povdoigt/Apex/Station_sol/README.md

# Apex
git hub du projet Apex
coucou les copains 

# Install / Uninstall

Curently the install and uninstall files are instaling the test vertion (testqt). It is only a desmonstrator and placeholder for the future etiration of it.

# ApexActual
Curently the main vertion a Apex, it while the structure for telemetry reads is present it isnt used. Mainly a way to show how the ui looks on the ground station.
