povdoigt/Apex/PCB/invoice.pdf

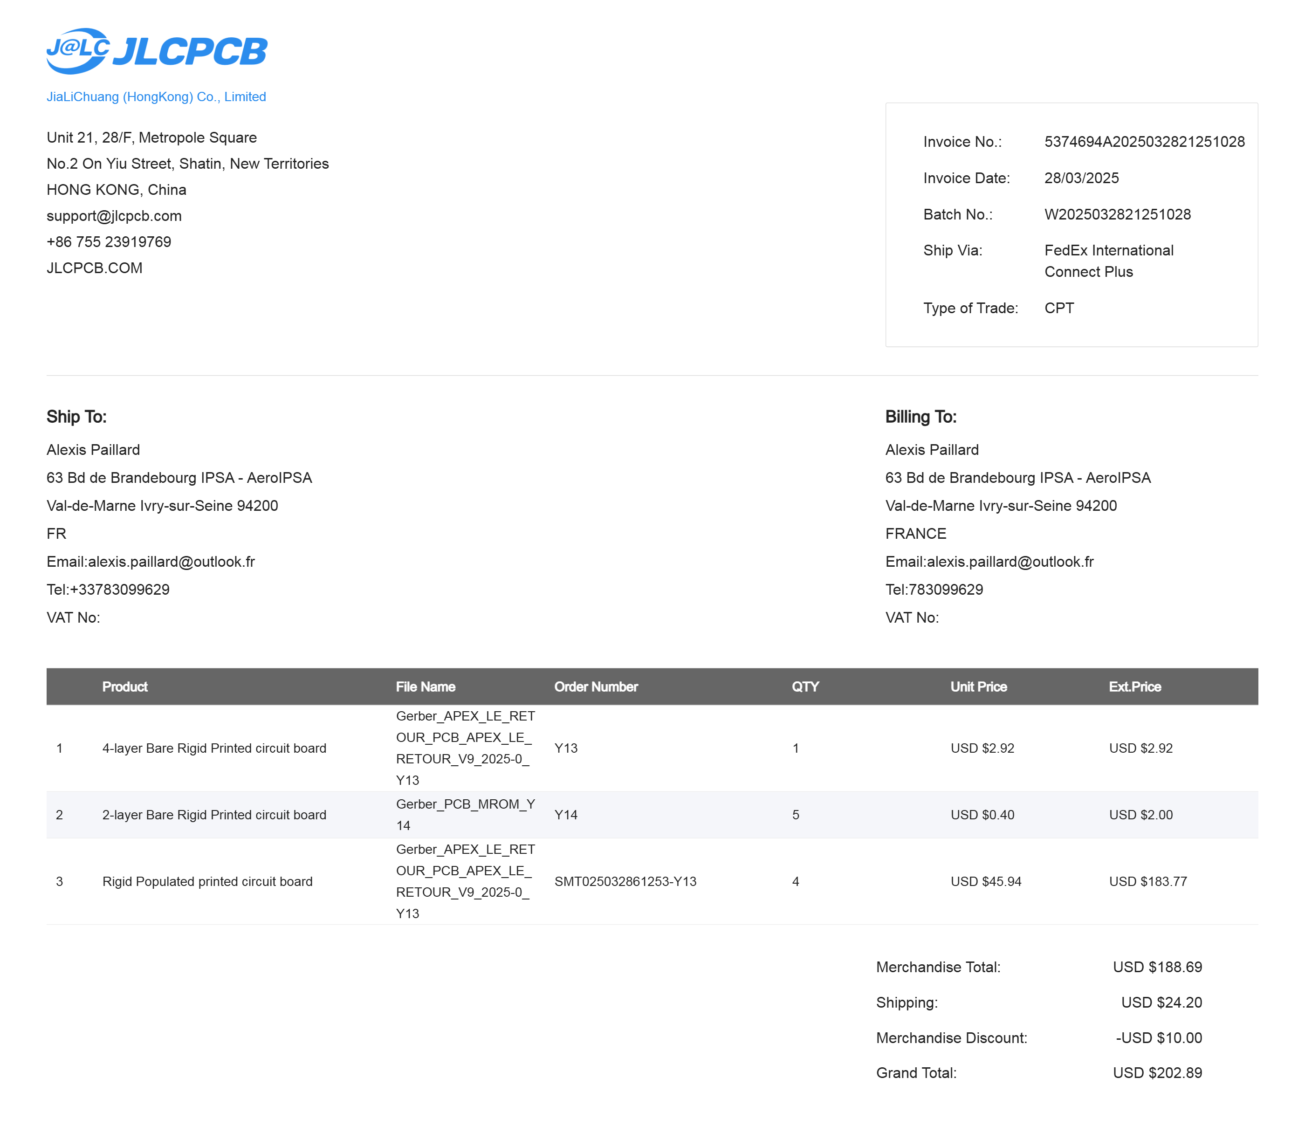
[picture p21: page 1]
