povdoigt/Apex/PCB/PCB_PCB_APEX_LE_RETOUR_V9_2025-04-03/Hole.pdf

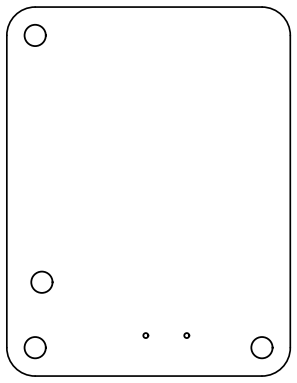
[picture p22: figure]
