povdoigt/Apex/PCB/invoice (1).pdf

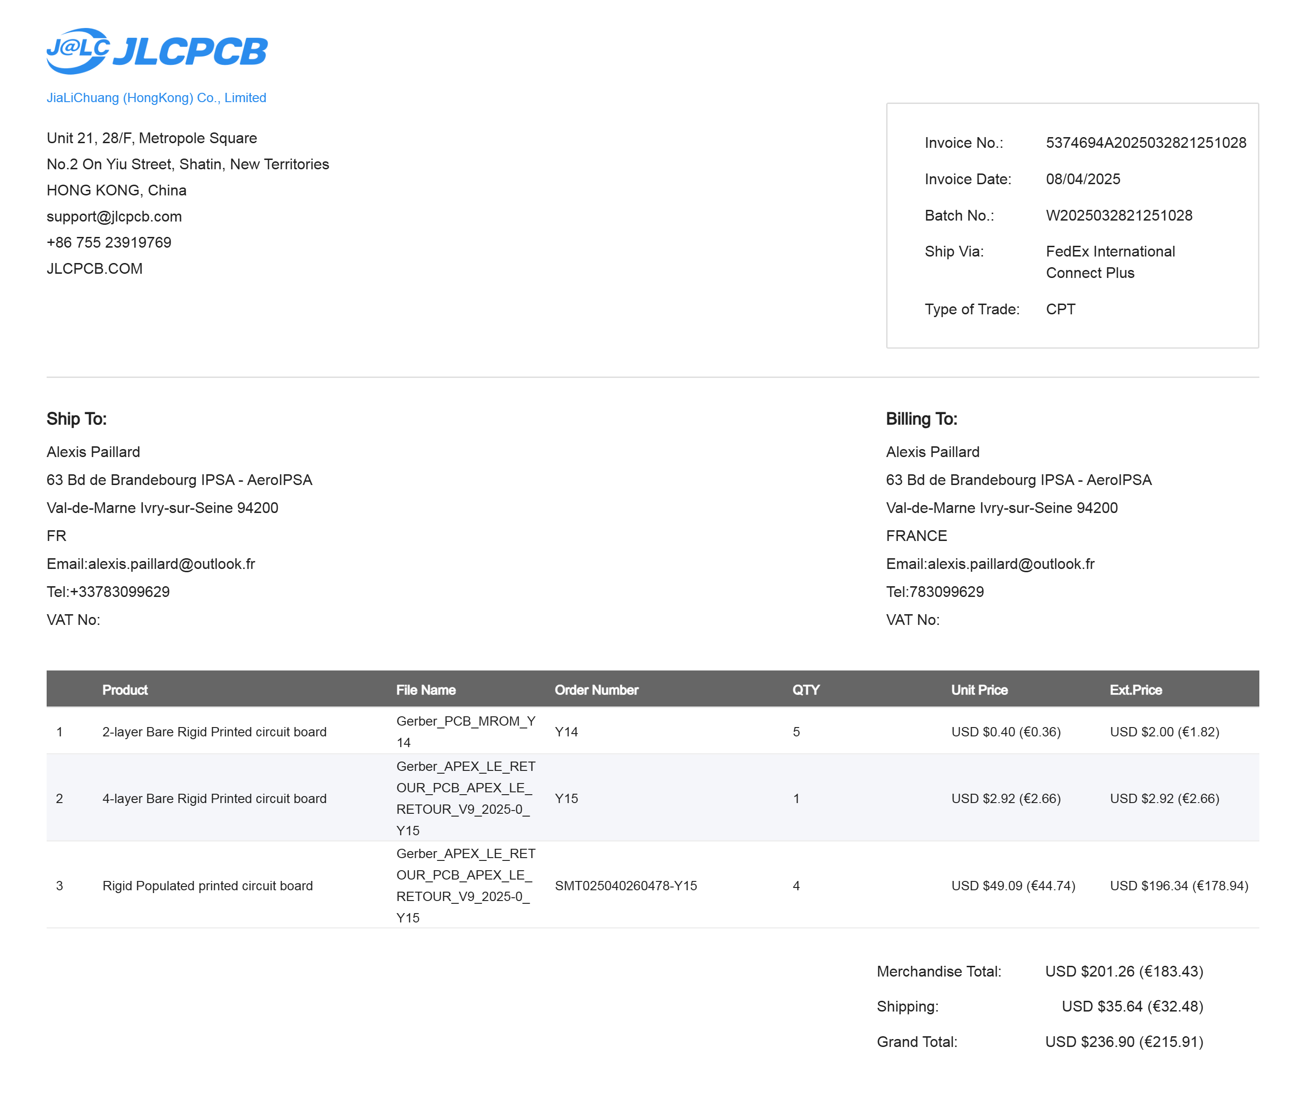
[picture p23: figure]
