povdoigt/Apex/APEX_DOC/APX_algo.drawio.png

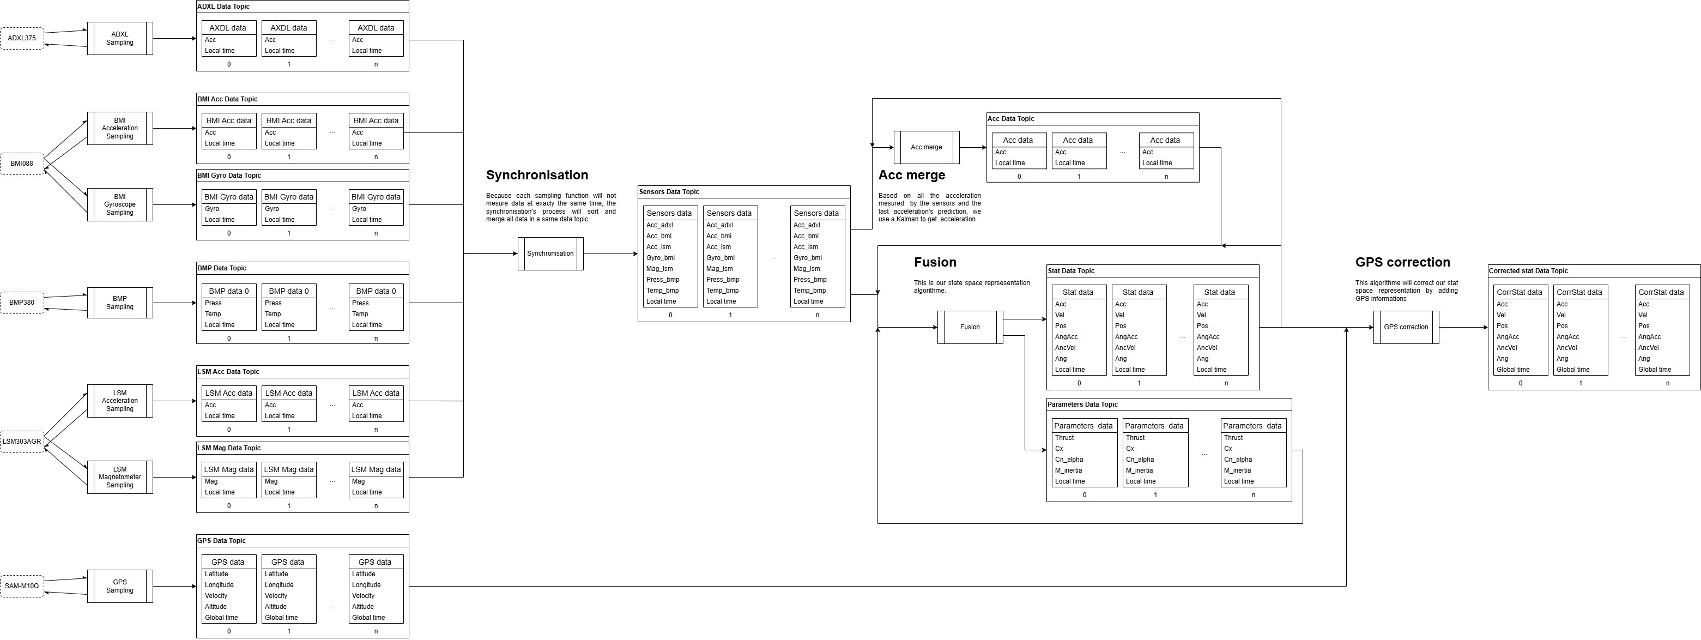
APEX_DOC/APX_algo.drawio.png
