povdoigt/Apex/Capture d’écran 2025-03-21 075751.png

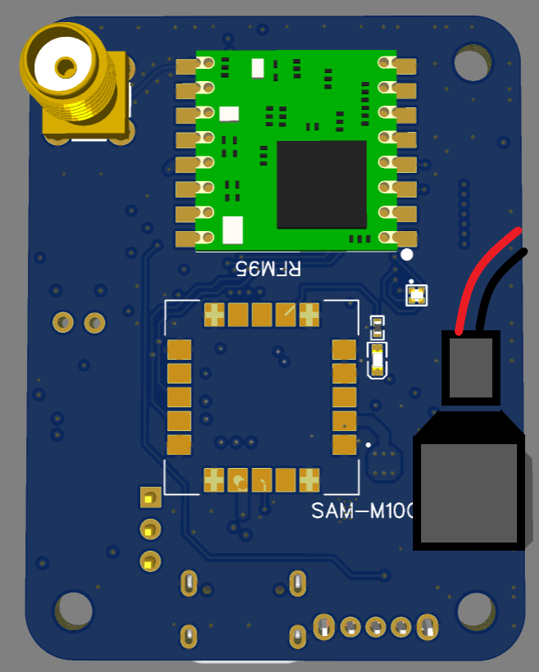
Capture d’écran 2025-03-21 075751.png
