povdoigt/Apex/image.png

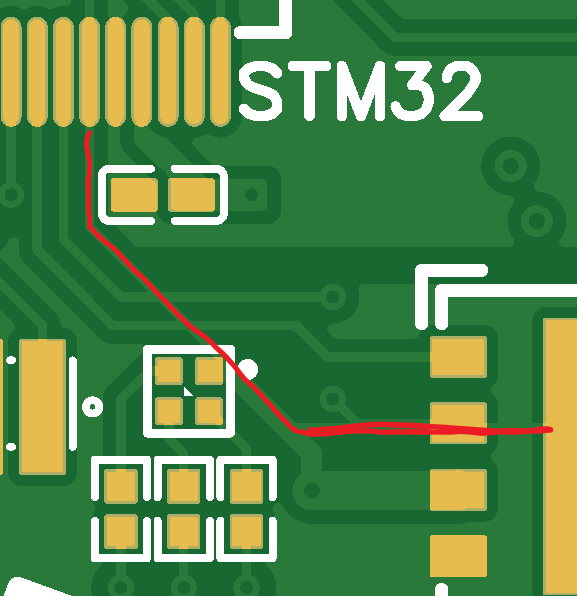
image.png
