povdoigt/Apex/PCB/APEX_BOTTOM.jpg

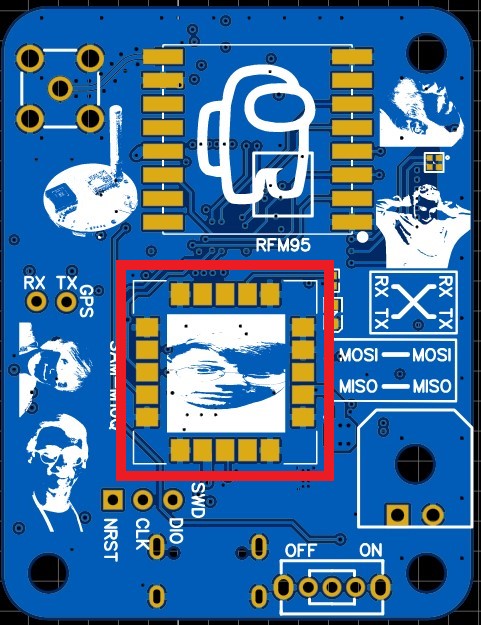
PCB/APEX_BOTTOM.jpg
