povdoigt/Apex/PCB/APEX_TOP.jpg

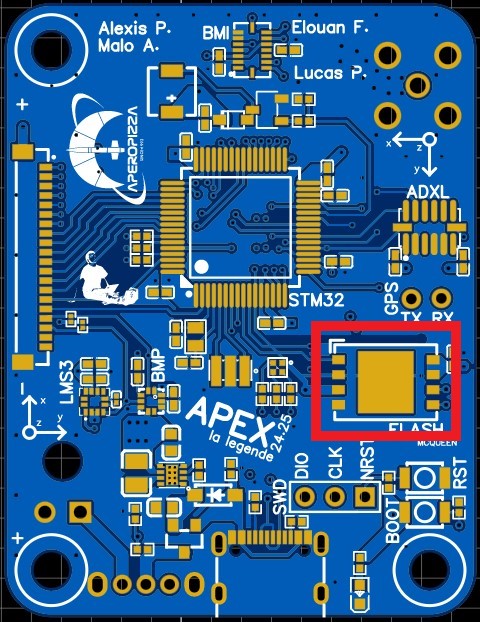
PCB/APEX_TOP.jpg
