povdoigt/Apex/PCB/Produce_DanZhi.SMT_Snapshot.Top.5374694A_Y15.SMT025040260478.png

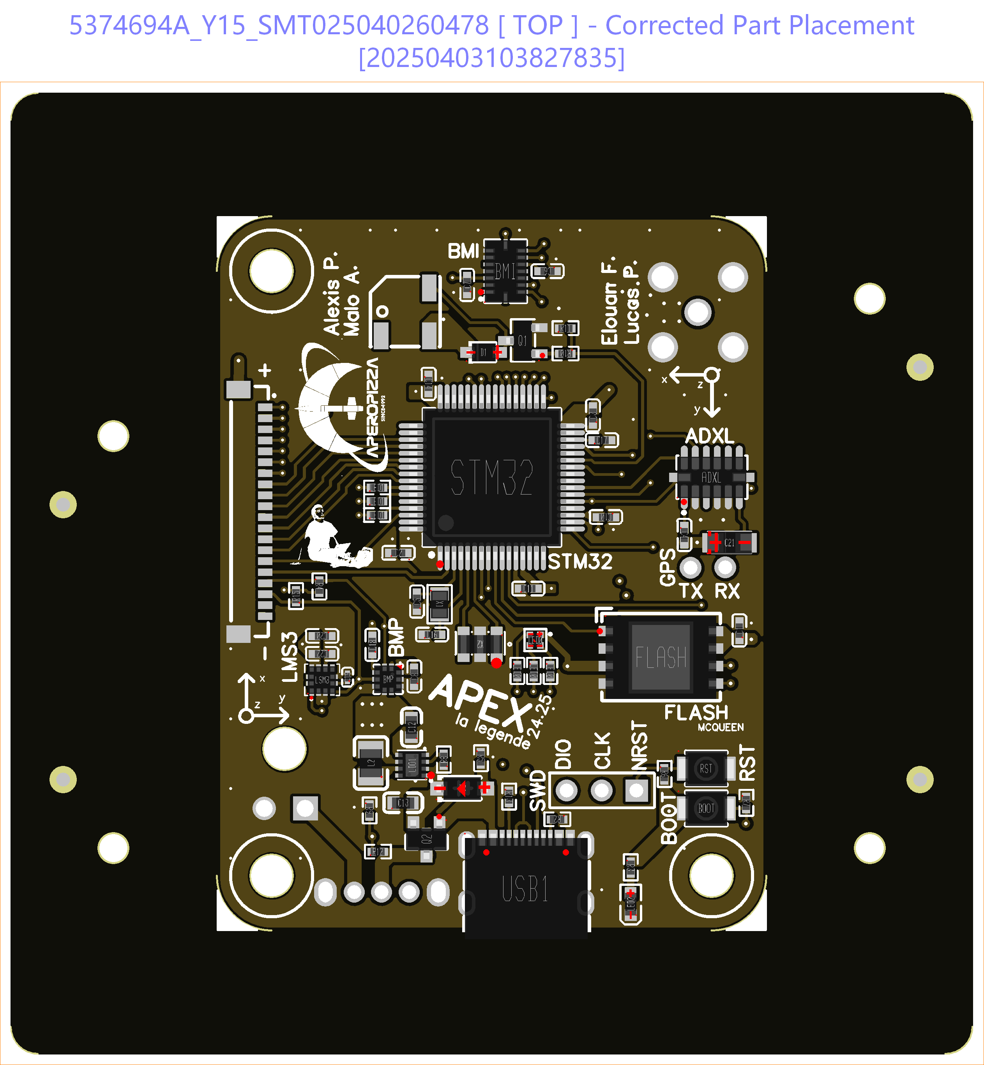
PCB/Produce_DanZhi.SMT_Snapshot.Top.5374694A_Y15.SMT025040260478.png
