povdoigt/Apex/rapport/image/PCB_PCB_APEX_LE_RETOUR_V9_2025-08-13.png

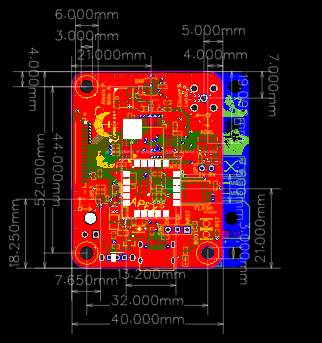
rapport/image/PCB_PCB_APEX_LE_RETOUR_V9_2025-08-13.png
