povdoigt/Apex/rapport/image/station_sol.jpg

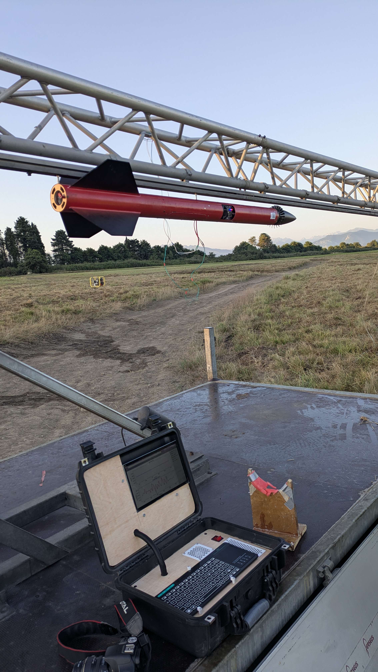
rapport/image/station_sol.jpg
