povdoigt/Apex/rapport/image/TopLayer_Graph.png

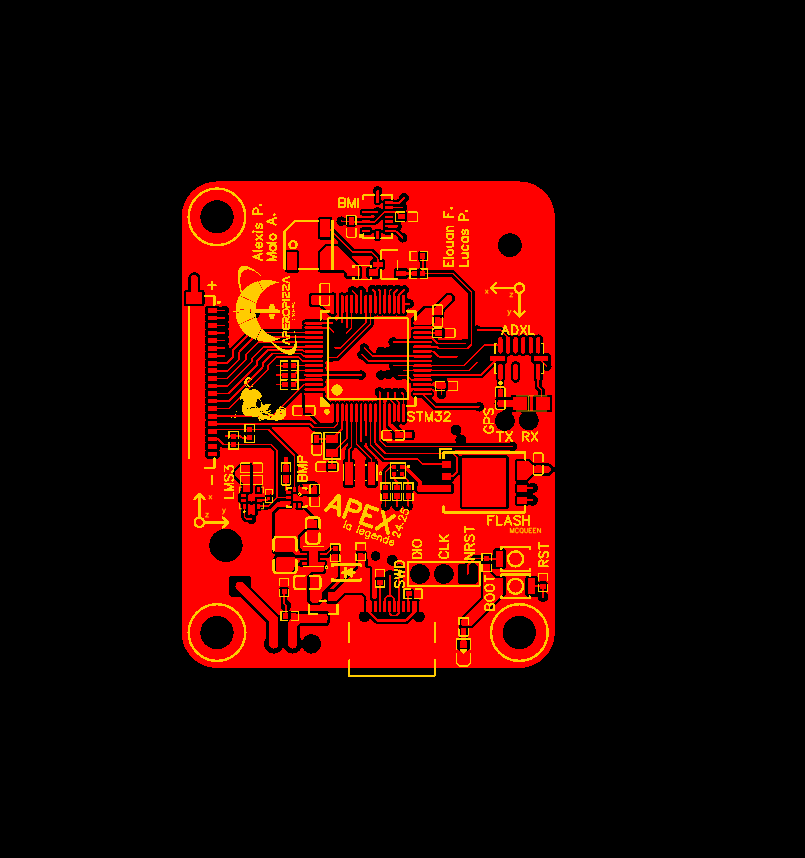
rapport/image/TopLayer_Graph.png
