povdoigt/Apex/Sans titre.png

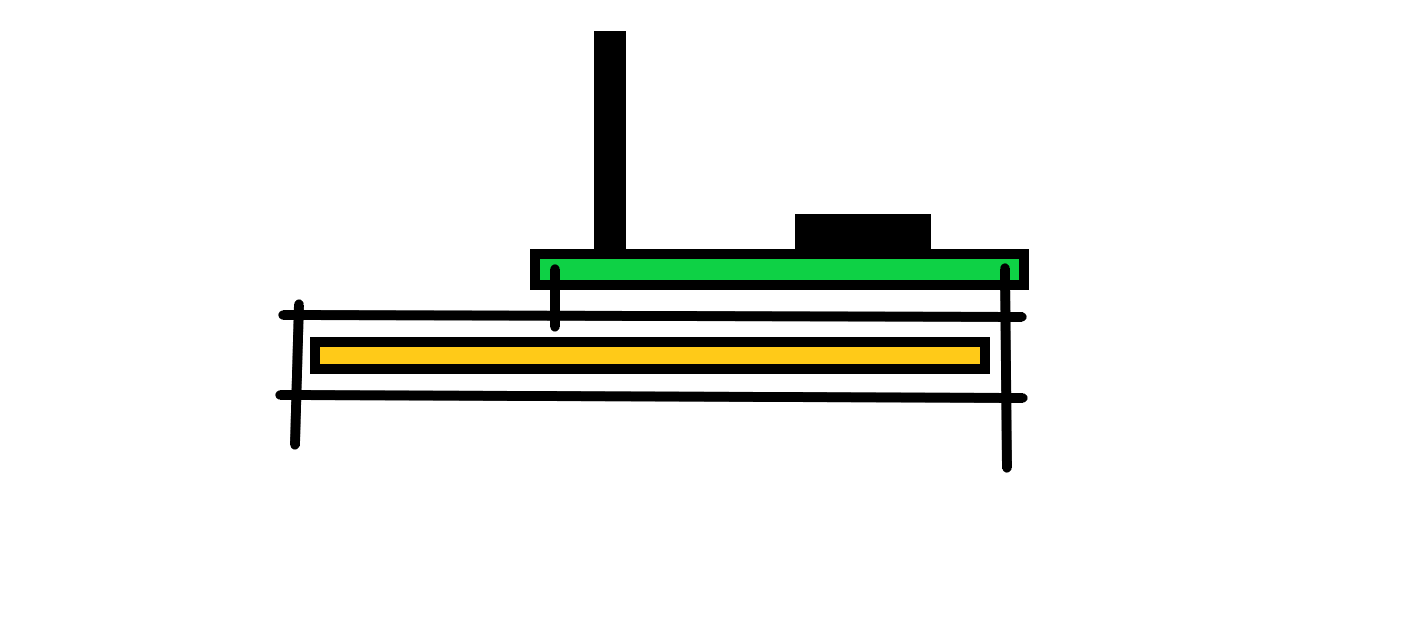
Sans titre.png
