povdoigt/Apex/PCB/BOM_APEX_LE_RETOUR_2025-04-02.csv

ID | Name | Designator | Footprint | Quantity | Manufacturer Part | Manufacturer | Supplier | Supplier Part | Price | Pins | 3DModel | Contributor | JLCPCB Part Class | description | image | link
1 | DL-RFM95-868M | RFM95 | COMM-SMD_RFM95W | 1 | DL-RFM95-868M | DreamLNK(骏晔科技) | LCSC | C2844472 | 7.067 | 16 | COMM-SMD_RFM95W | lcsc | Extended Part |  |  | https://www.hoperf.com/modules/lora/RFM95.html
2 | 436500200 | CONNECT1 | CONN-TH_2P-P3.00_MOLEX_436500200 | 1 | 436500200 | MOLEX | LCSC | C192562 | 0.506 | 2 | CONN-TH_2P-P3.00_MOLEX_436500200 | LCSC | Extended Part |  |  | https://atta.szlcsc.com/upload/public/pdf/source/20200310/C493449_4DC7260CE271CBA6D2154088F48DA7E5.pdf
3 | SMLP34RGBN1W3 | LED1,LED0 | LED-ARRAY-SMD_4P-L1.00-W1.00-TR | 2 | SMLP34RGBN1W3 | ROHM(罗姆) | LCSC | C6680390 | 0.851 | 4 | LED1010-4P_L1.0-W1.0-H0.2-LS1.0 | lcsc | Extended Part |  |  | https://item.szlcsc.com/391389.html
4 | 1kΩ | R1,R3,R10 | R0402 | 3 | CR0402JF0102G | LIZ(丽智电子) | LCSC | C100571 |  | 2 | R0402_L1.0-W0.5-H0.4 | lcsc | Extended Part |  |  | https://item.szlcsc.com/323315.html
5 | SAM-M10Q-00B | SAM-M10Q | XCVR_SAM-M10Q-00B | 1 |  |  |  |  |  | 20 |  | Jonathan Asta
6 | RED | LED4,LED2 | LED0603-RD | 2 | KT-0603R | KENTO | LCSC | C2286 | 0.006 | 2 | LED0603-RD | lcsc | Basic Part |  |  | https://item.szlcsc.com/347874.html
7 | HJ-SMA058 | RF1 | SMA-TH_BWSMA-KE-Z001 | 1 | HJ-SMA058 | 皇捷 | LCSC | C2693814 | 0.98 | 5 | SMA-TH_5P-L6.5-W6.5-H9.8_BWSMA-KE-Z001 | LCSC | Extended Part |  |  | https://item.szlcsc.com/508498.html
8 | SS-12D07-L4-B | SW4 | SW-TH_SS-12D07-X-X | 1 | SS12D07L4B | XKB Connectivity(中国星坤) | LCSC | C480344 | 0.078 | 5 | SW-TH_SS-12D07-X-X | LCSC | Extended Part |  |  | https://item.szlcsc.com/487808.html?ref=editor&logined=true
9 | 10uF | C21 | CASE-A_3216 | 1 | TC212A106M010A | Sunlord(顺络) | LCSC | C97063 |  | 2 | CASE-A_3216 | lcsc | Extended Part |  |  | https://item.szlcsc.com/2057730.html
10 | ST-0503 | BUZZER1 | BUZ-SMD_3P-L5.0-W5.0-BL | 1 | ST-0503 | Soberton(索伯顿) | LCSC | C7090163 | 4.227 | 3 | BUZ-SMD_3P-L5.0-W5.0-H3.0-BL | lcsc | Extended Part |  |  | https://item.szlcsc.com/2808733.html
11 | 4.7kΩ | R4,R15 | R0402 | 2 | 0402WGF4701TCE | UNI-ROYAL(厚声) | LCSC | C25900 | 0.001 | 2 | R0402_L1.0-W0.5-H0.4 | lcsc | Basic Part |  |  | https://item.szlcsc.com/323315.html
12 | ADXL375BCCZ-RL7 | ADXL | LGA-14_L5.0-W3.0-P0.80-BL | 1 | ADXL375BCCZ-RL7 | ADI(亚德诺) | LCSC | C481898 | 5.674 | 14 | LGA-14_L3.0-W5.0-H1.0-P0.80 | LCSC | Extended Part |  |  | https://item.szlcsc.com/221876.html
13 | TYPE-C 16PIN 2MD(073) | USB1 | USB-C-SMD_TYPE-C-6PIN-2MD-073 | 1 | TYPE-C 16PIN 2MD(073) | SHOU HAN(首韩) | LCSC | C2765186 | 0.059 | 16 | USB-C-SMD_TYPE-C-6PIN-2MD-073 | LCSC | Extended Part |  |  | https://atta.szlcsc.com/upload/public/pdf/source/20210409/C2765186_34D42616F62DF94D17C4D63D74D9FD03.pdf
14 | 220nF | C19 | C0201 | 1 | CGA0201X5R224M6R3ET | HRE(芯声) | LCSC | C36911344 | 0.002 | 2 | C0201_L0.6-W0.3-H0.3 | lcsc | Extended Part |  |  | https://item.szlcsc.com/360022.html
15 | 100nF | C20,C18,C1,C4,C6,C7,C8,C14,C11,C10,C3,C2 | C0402 | 12 | CL05B104KB54PNC | SAMSUNG(三星) | LCSC | C307331 | 0.005 | 2 | C0402_L1.0-W0.5-H0.5 | LCSC | Basic Part |  |  | https://item.szlcsc.com/15869.html
16 | 10uF | C22 | C0402 | 1 | GRM155R60J106ME44D | muRata(村田) | LCSC | C76991 | 0.006 | 2 | C0402_L1.0-W0.5-H0.5 | lcsc |  |  |  | https://item.szlcsc.com/15869.html
17 | LSM303AGRTR | LSM3 | LGA-12_L2.0-W2.0-P0.50-BL | 1 | LSM303AGRTR | ST(意法半导体) | LCSC | C126671 | 2.2 | 12 | LGA-12_L2.0-W2.0-H1.0-P0.50 | LCSC | Extended Part | LGA-12 2x2x1 mm 12-lead |  | https://so.szlcsc.com/global.html?c=&k=C915682
18 | 20Ω | RLED1G,RLED0G | R0402 | 2 | 0402WGF200JTCE | UNI-ROYAL(厚声) | LCSC | C25089 | 0.001 | 2 | R0402_L1.0-W0.5-H0.4 | lcsc | Extended Part |  |  | https://item.szlcsc.com/323315.html
19 | 180Ω | RLED1R,RLED0R | R0402 | 2 | 0402WGJ0181TCE | UNI-ROYAL(厚声) | LCSC | C25145 |  | 2 | R0402_L1.0-W0.5-H0.4 | lcsc | Extended Part |  |  | https://item.szlcsc.com/323315.html
20 | 4.7uF | C17 | C0402 | 1 | CL05A475MP5NRNC | SAMSUNG(三星) | LCSC | C23733 | 0.005 | 2 | C0402_L1.0-W0.5-H0.5 | lcsc | Basic Part |  |  | https://item.szlcsc.com/15869.html
21 | 12pF | C5,C16 | C0402 | 2 | 0402CG120J500NT | FH(风华) | LCSC | C1547 | 0.001 | 2 | C0402_L1.0-W0.5-H0.5 | lcsc | Basic Part |  |  | https://item.szlcsc.com/15869.html
22 | 5.1kΩ | R2,R13 | R0402 | 2 | WR04X5101FTL | Walsin(华新科) | LCSC | C163833 | 0.001 | 2 | R0402_L1.0-W0.5-H0.4 | LCSC | Extended Part |  |  | https://item.szlcsc.com/323315.html
23 | 10kΩ | R5,R6,R7,R11 | R0402 | 4 | CR0402J10K0Q10Z | EVER OHMS(天二科技) | LCSC | C881063 |  | 2 | R0402_L1.0-W0.5-H0.4 | LCSC | Extended Part |  |  | https://item.szlcsc.com/323315.html
24 | 100kΩ | R8,R9,R12 | R0402 | 3 | CR0402FF1003G | LIZ(丽智电子) | LCSC | C100197 | 0.001 | 2 | R0402_L1.0-W0.5-H0.4 | lcsc | Extended Part |  |  | https://item.szlcsc.com/323315.html
25 | 100Ω | RLED0B,RLED1B | R0402 | 2 | 0402WGF1000TCE | UNI-ROYAL(厚声) | LCSC | C25076 | 0.001 | 2 | R0402_L1.0-W0.5-H0.4 | lcsc | Basic Part |  |  | https://item.szlcsc.com/323315.html
26 | BMI088 | BMI | LGA-16_L4.5-W3.0-P0.50-BL | 1 | BMI088 | Bosch(博世) | LCSC | C194919 | 2.85 | 16 | LGA-16_L4.5-W3.0-H1.0-P0.50-BL | VincenT | Extended Part |  |  | https://item.szlcsc.com/202245.html
27 | BMP388 | BMP | SENSORM-SMD_BMP388 | 1 | BMP388 | Bosch(博世) | LCSC | C779278 | 1.241 | 10 | SENSORM-SMD_BMP388 | zertyme | Extended Part |  |  | https://img.jlc.com/pdf/applyPasteComponent/2021-07-27/72509S/0ae1b856437e4f5dbcf1b52e85733e2c/BST_BMP388_DS001-1509617.pdf
28 | STM32F411RET6 | STM32 | LQFP-64_L10.0-W10.0-P0.50-LS12.0-BL | 1 | STM32F411RET6 | ST(意法半导体) | LCSC | C94355 | 3.106 | 64 | LQFP-64_L10.0-W10.0-H1.4-LS12.0-P0.50 | lcsc | Extended Part |  |  | https://item.szlcsc.com/92458.html
29 | W25Q512JVEIQ | FLASH | WSON-8_L8.0-W6.0-P1.27-TL-EP | 1 | W25Q512JVEIQ | WINBOND(华邦) | LCSC | C2986165 | 4.606 | 9 | WSON-8_L8.0-W6.0-P1.27-TL-EP | lcsc | Extended Part |  |  | https://item.szlcsc.com/2733083.html
30 | 2147210200 | U4 | CONN-SMD_20P-P0.80_2147210200 | 1 | 2147210200 | MOLEX | LCSC | C6076426 | 1.252 | 22 | CONN-SMD_20P-P0.80_2147210200 | lcsc | Extended Part |  |  | https://www.molex.com/content/dam/molex/molex-dot-com/products/automated/en-us/salesdrawingpdf/214/214721/2147210200_sd.pdf
31 | B3U-1000P | BOOT,RST | KEY-SMD_B3U-1000PM | 2 | B3U-1000P | OMRON(欧姆龙) | LCSC | C231329 | 0.153 | 2 | KEY-SMD_2P-L3.0-W2.5-H1.6-LS4.0 | LCSC | Extended Part |  |  | https://item.szlcsc.com/260788.html
32 | HDR-M-2.54_1x3 | J2 | HDR-M-2.54_1X3 | 1 |  |  | LCSC | C180248 | 0.135 | 3 |  | LCEDA_Lib
33 | 20MHz | X2 | CRYSTAL-SMD_3P-L3.2-W1.3-P1.2-BL | 1 | CSTNE20M0V530000R0 | muRata(村田) | LCSC | C882604 | 0.232 | 3 | CRYSTAL-SMD_3P-L3.2-W1.3-P1.2-BL | lcsc | Extended Part |  |  | https://atta.szlcsc.com/upload/public/pdf/source/20201022/C907957_8E07C565874D4A99F6305262E18BC732.pdf
34 | 32.768kHz | X1 | CRYSTAL-SMD_L2.0-W1.2 | 1 | 9H03200012 | TXC(晶技) | LCSC | C90943 | 0.216 | 2 | CRYSTAL-SMD_L2.0-W1.2 | lcsc | Extended Part |  |  | https://atta.szlcsc.com/upload/public/pdf/source/20181030/C253726_1AF56EE5F475445978CFBD53AF301042.pdf
35 | AO3401A | Q2 | SOT-23_L2.9-W1.3-P1.90-LS2.4-BR | 1 | AO3401A | AOS | LCSC | C15127 | 0.053 | 3 | SOT-23-3P_L2.9-W1.3-H1.0-LS2.4-P0.95 | lcsc | Basic Part |  |  | https://item.szlcsc.com/236142.html
36 | AO3400A | Q1 | SOT-23-3_L2.9-W1.6-P1.90-LS2.8-BR | 1 | AO3400A | AOS | LCSC | C20917 | 0.106 | 3 | SOT-23-3L_L2.9-W1.6-H1.1-LS2.8-P0.95 | lcsc | Basic Part |  |  | https://item.szlcsc.com/14454.html
37 | TPS62172DSGR | LDO1 | WSON-8_L2.0-W2.0-P0.50-TL-EP | 1 | TPS62172DSGR | TI(德州仪器) | LCSC | C59873 | 0.555 | 9 | WSON-8_L2.0-W2.0-H0.8-P0.50 | zertyme | Extended Part |  |  | https://www.ti.com/cn/lit/ds/symlink/tps61021a.pdf?ts=1620961904170
38 | 2.2uH | L2 | L0806 | 1 | MLP2016V2R2MT0S1 | TDK | LCSC | C307746 | 0.076 | 2 | L0806_L2.0-W1.6-H1.0 | LCSC | Extended Part |  |  | https://item.szlcsc.com/94074.html
39 | B5819W | D3 | SOD-123_L2.7-W1.6-LS3.7-RD-1 | 1 | B5819W SL | CJ(江苏长电/长晶) | LCSC | C8598 | 0.023 | 2 | SOD-123_L2.7-W1.6-LS3.7-RD-1 | lcsc | Basic Part |  |  | https://atta.szlcsc.com/upload/public/pdf/source/20210423/C2828417_EF1BF8BE3D48F97E320B09B073C89160.pdf
40 | 1N5819WS | D1 | SOD-323_L1.8-W1.3-LS2.5-RD | 1 | 1N5819WS | Hottech(合科泰) | LCSC | C191023 | 0.01 | 2 | SOD-323_L1.7-W1.3-H1.1-LS2.5 | LCSC | Basic Part |  |  | https://item.szlcsc.com/295156.html
41 | 10uF | C13 | C0603 | 1 | CL10A106KP8NNNC | SAMSUNG(三星) | LCSC | C19702 | 0.006 | 2 | C0603_L1.6-W0.8-H0.8 | lcsc | Basic Part |  |  | https://item.szlcsc.com/362304.html
42 | 22uF | C12 | C0603 | 1 | CL10A226MQ8NRNC | SAMSUNG(三星) | LCSC | C59461 | 0.008 | 2 | C0603_L1.6-W0.8-H0.8 | lcsc | Basic Part |  |  | https://item.szlcsc.com/362304.html
