povdoigt/Apex/(list of files, cad)

Other CAD files:
APEX_CATIA/3D_PCB_PCB_APEX_LE_RETOUR_V9_2025-03-28_2025-03-28.CATProduct
APEX_CATIA/COMPOUND.CATPart
APEX_CATIA/COMPOUND_1.CATPart
APEX_CATIA/COMPOUND_10.CATPart
APEX_CATIA/COMPOUND_11.CATPart
APEX_CATIA/COMPOUND_12.CATPart
APEX_CATIA/COMPOUND_13.CATPart
APEX_CATIA/COMPOUND_14.CATPart
APEX_CATIA/COMPOUND_15.CATPart
APEX_CATIA/COMPOUND_16.CATPart
APEX_CATIA/COMPOUND_17.CATPart
APEX_CATIA/COMPOUND_19.CATPart
APEX_CATIA/COMPOUND_2.CATPart
APEX_CATIA/COMPOUND_20.CATPart
APEX_CATIA/COMPOUND_3.CATPart
APEX_CATIA/COMPOUND_4.CATPart
APEX_CATIA/COMPOUND_5.CATPart
APEX_CATIA/COMPOUND_6.CATPart
APEX_CATIA/COMPOUND_7.CATPart
APEX_CATIA/COMPOUND_8.CATPart
APEX_CATIA/COMPOUND_9.CATPart
APEX_CATIA/SOLID.CATPart
APEX_CATIA/SOLID_1.CATPart
APEX_CATIA/Wde2-BMP-SENSORM-SMD_BMP388.CATPart
APEX_CATIA/Wde2-BUZZER-BUZ-SMD_L4.0-W4.0-P3.50-L.CATPart
APEX_CATIA/Wde2-Board.CATPart
APEX_CATIA/Wde2-C13-C0603.CATPart
APEX_CATIA/Wde2-C20-C0402.CATPart
APEX_CATIA/Wde2-D3-SOD-123_L2.7-W1.6-LS3.7-RD-1.CATPart
APEX_CATIA/Wde2-L2-L0806.CATPart
APEX_CATIA/Wde2-U4-CONN-SMD_20P-P0.80_2147210200.CATPart
APEX_CATIA/Wde2-X1-CRYSTAL-SMD_L2.0-W1.2.CATPart
APEX_CATIA/Wde2-X2-CRYSTAL-SMD_3P-L3.2-W1.3-P1.2-BL.CATPart
logo_v1.CATPart
