povdoigt/Apex/APEX_DOC/Schematic_APEX_LE_RETOUR_2025-04-03.pdf

# LORA

# +3V3 SDA

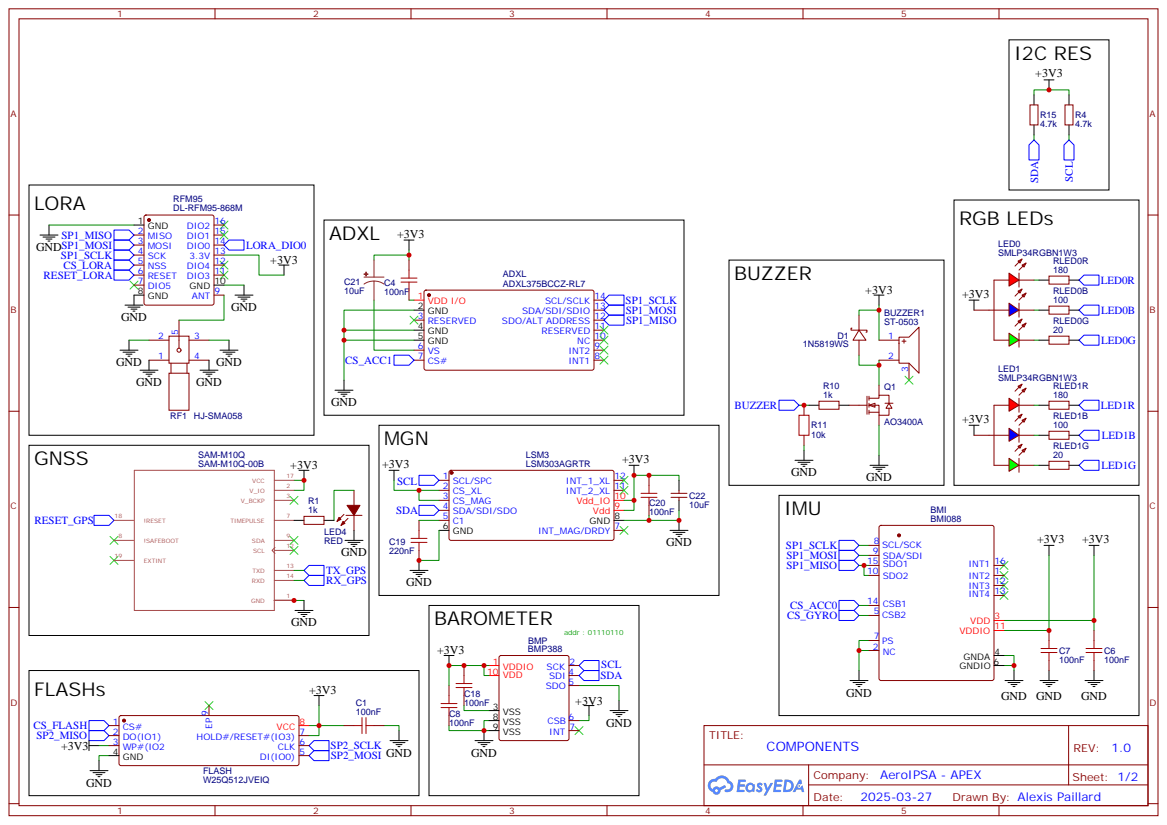
[picture p36: page 1]

Drawn By: Alexis Paillard

PA3 17 VSS 18 VDD 19 PA4 20 PA5 21 PA6 22 PA7 23 PC4 24 PC5 25 PB0 26 PB1 27 PB2 28 PB10 29 VCAP_1 30 VSS 31 VDD 32

# RESET

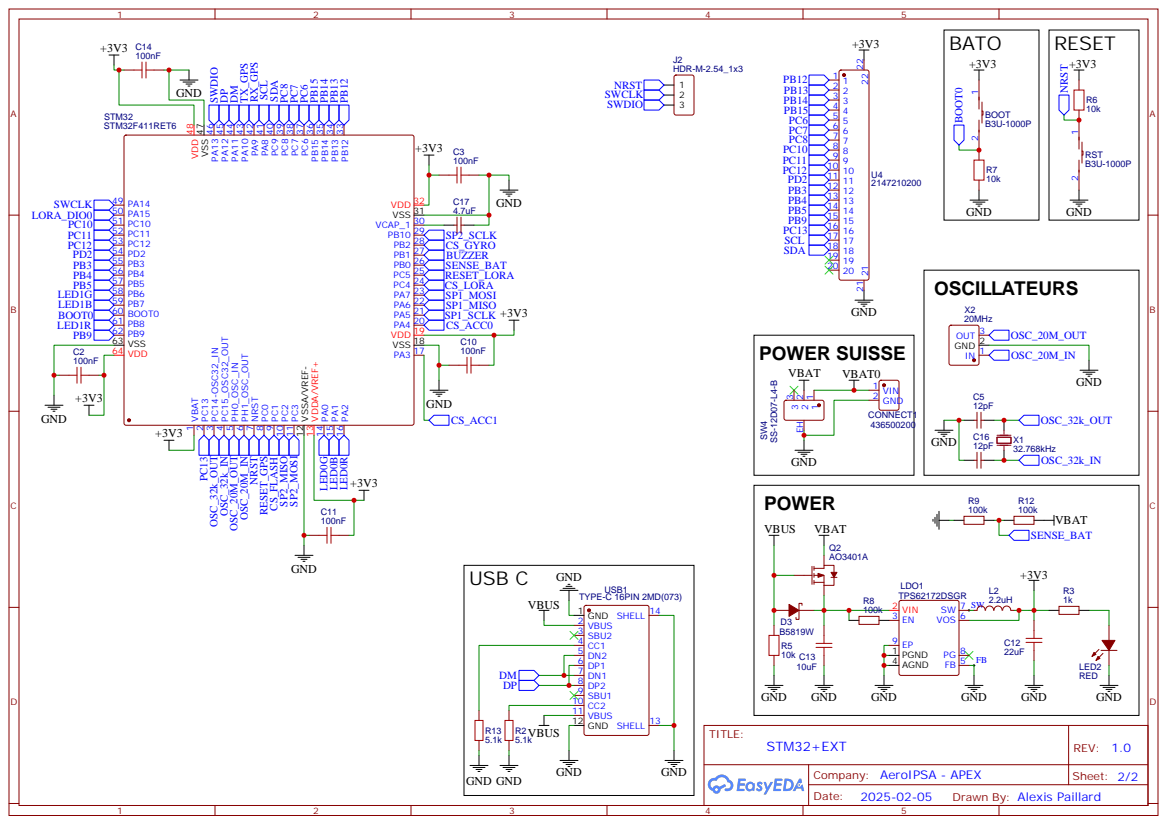
[picture p37: page 2]

Drawn By: Alexis Paillard
