povdoigt/Apex/APEX_DOC/PCB_APEX_BOTTOM.pdf

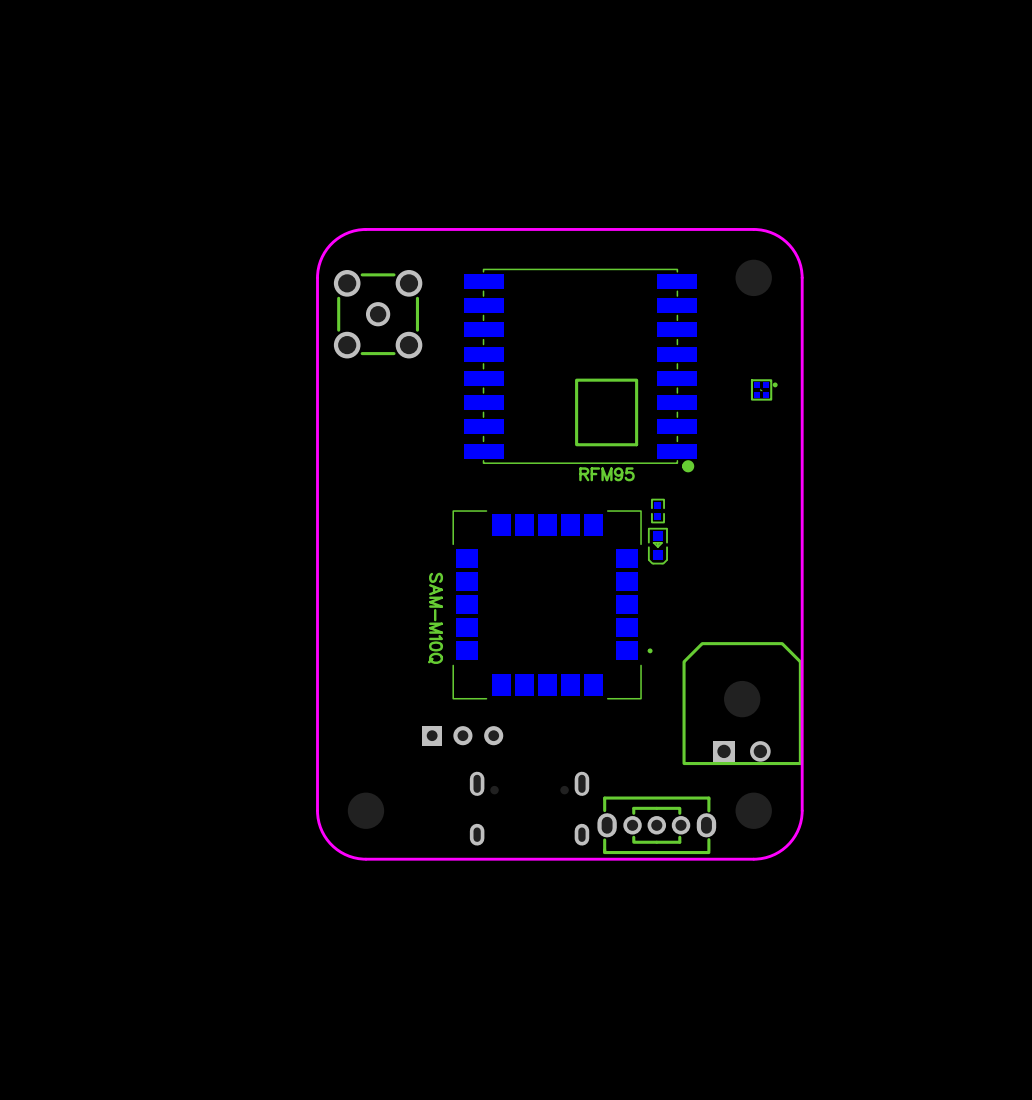
[picture p38: page 1]
