povdoigt/Apex/APEX_DOC/PCB_APEX_geometry.pdf

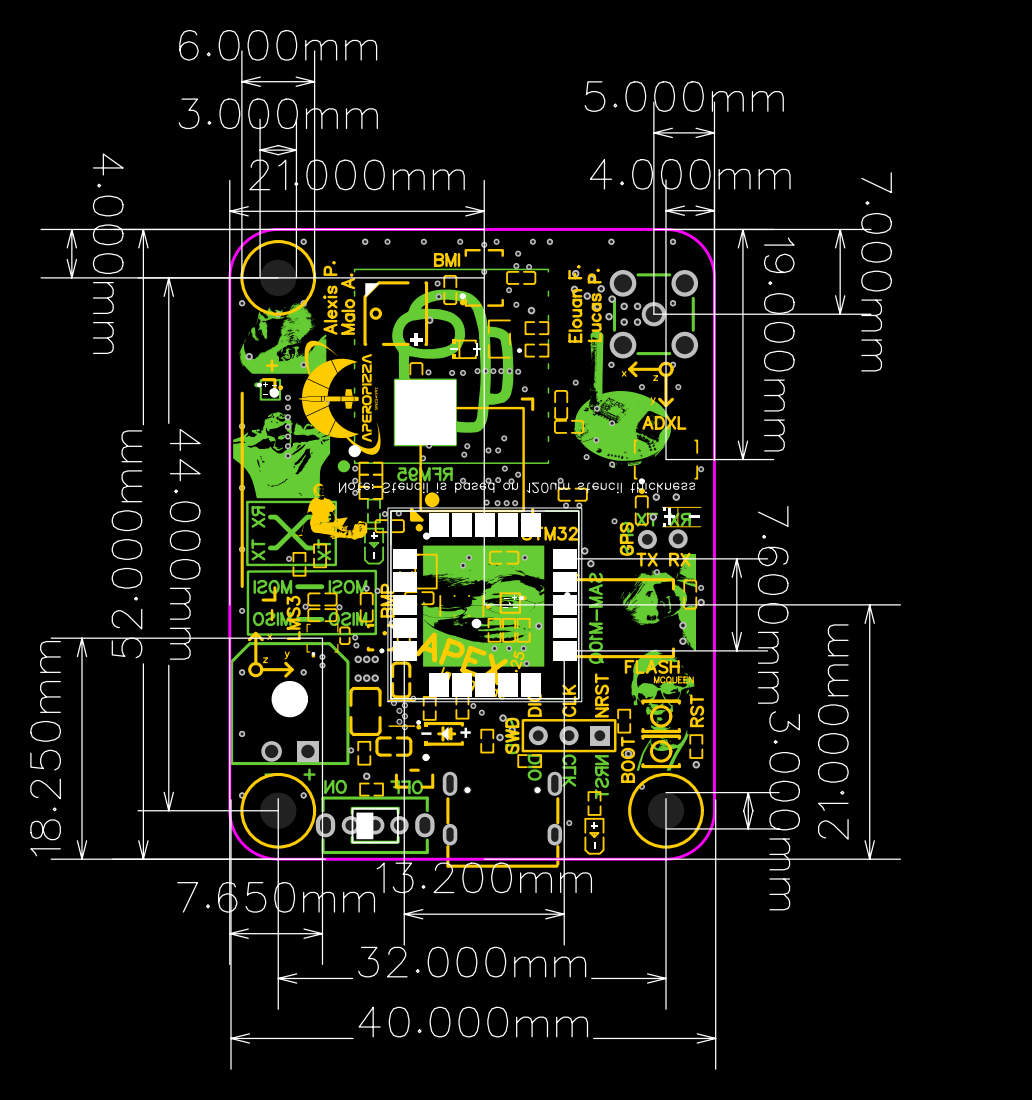
[picture p39: page 1]
