povdoigt/Apex/APEX_DOC/PCB_APEX_TOP.pdf

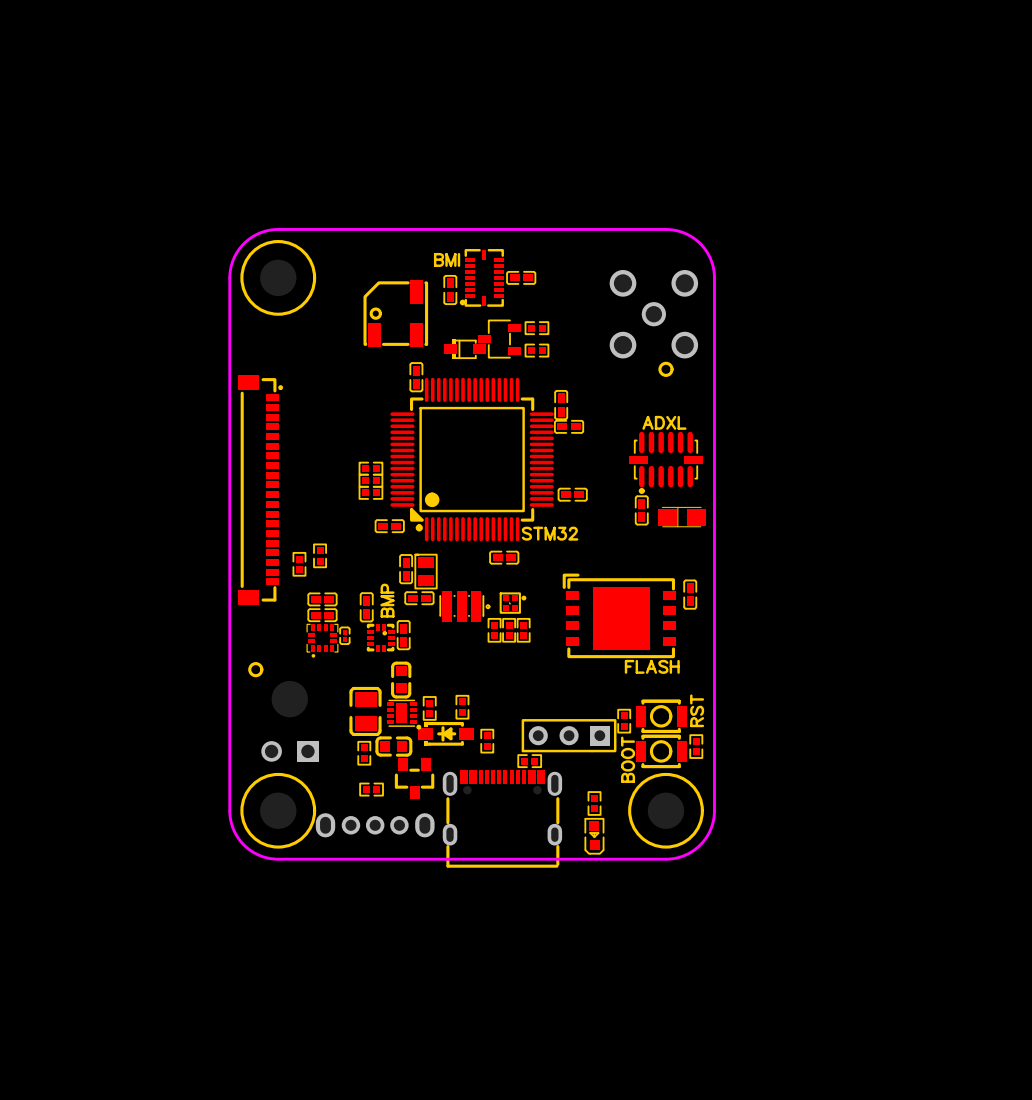
[picture p40: page 1]
