povdoigt/Apex/APEX_DOC/PCB_PCB_APEX_LE_RETOUR_V9_2025-04-04.pdf

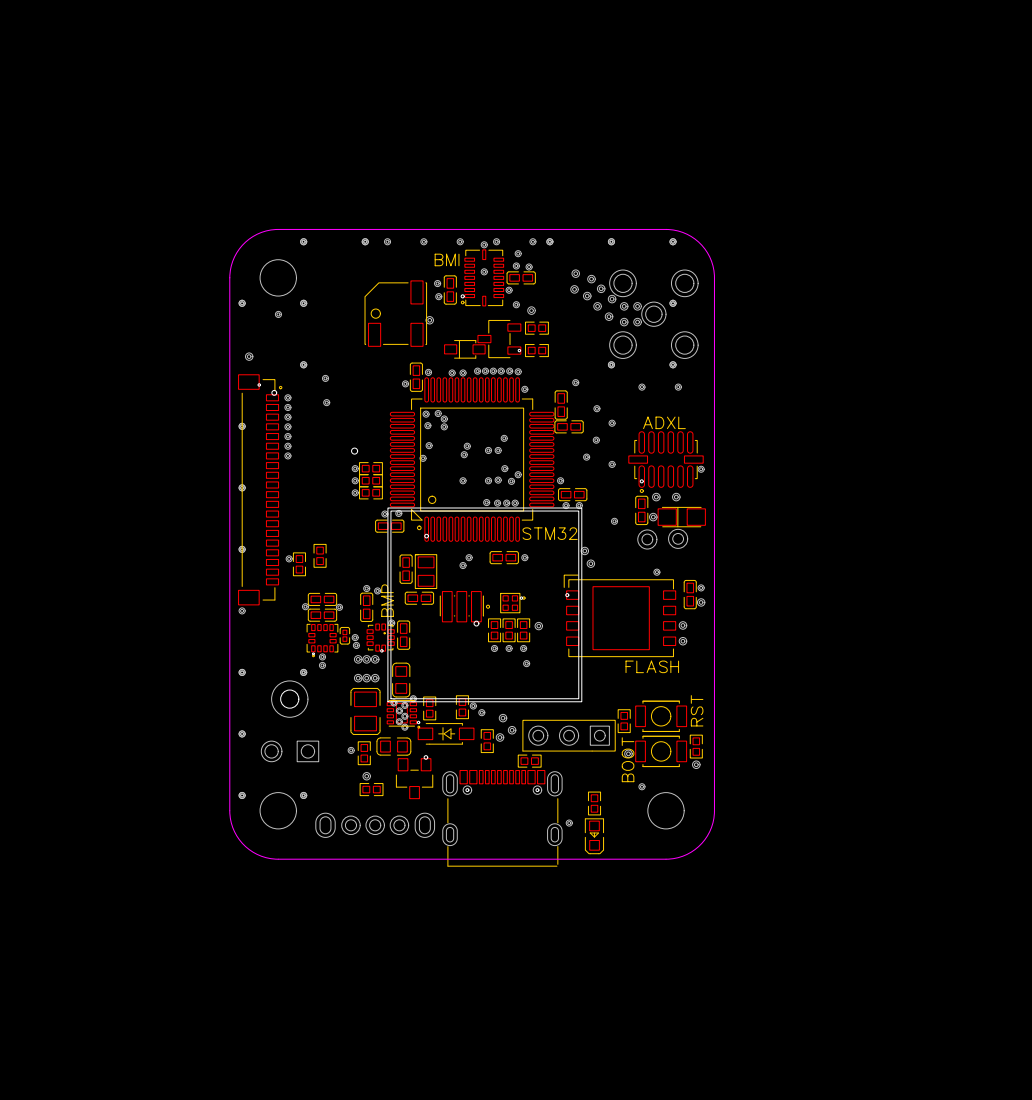
[picture p41: page 1]
