povdoigt/Apex/PCB/PCB_PCB_APEX_LE_RETOUR_V9_2025-04-03/BottomLayer.pdf

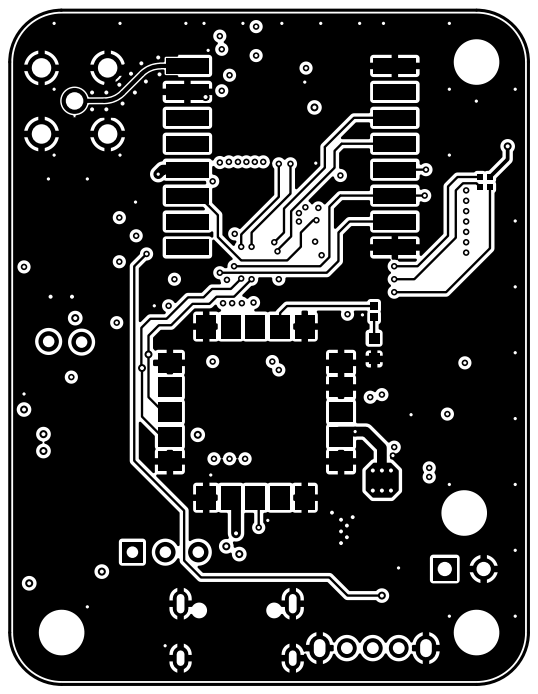
[picture p42: page 1]
