povdoigt/Apex/PCB/PCB_PCB_APEX_LE_RETOUR_V9_2025-04-03/Inner2.pdf

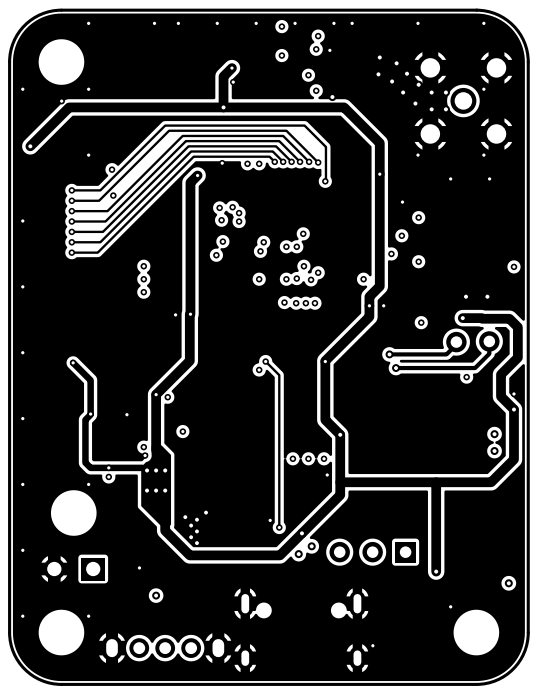
[picture p46: page 1]
