povdoigt/Apex/PCB/PCB_PCB_APEX_LE_RETOUR_V9_2025-04-03/Multi-Layer.pdf

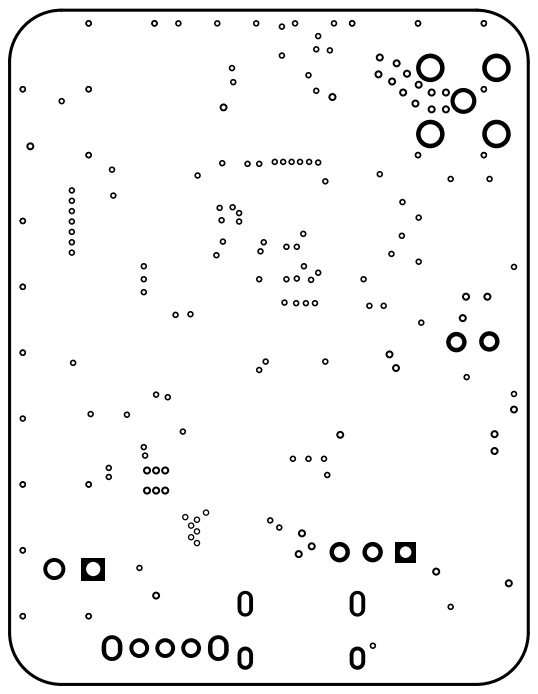
[picture p47: page 1]
