povdoigt/Apex/KODE/APEX_v1_1/Core/Src/main.c

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
/* Includes ------------------------------------------------------------------*/
#include "main.h"
#include "cmsis_os.h"
#include "adc.h"
#include "crc.h"
#include "dma.h"
#include "i2c.h"
#include "spi.h"
#include "tim.h"
#include "usart.h"
#include "usb_device.h"
#include "gpio.h"

/* USER CODE BEGIN Includes */

#include "usbd_cdc_if.h"

#include "project.h"

#include "adc.h"
#include "crc.h"
#include "dma.h"
#include "i2c.h"
#include "spi.h"
#include "tim.h"
#include "usart.h"
#include "gpio.h"

/* USER CODE END Includes */


void SystemClock_Config(void);
void MX_FREERTOS_Init(void);
/* USER CODE BEGIN PFP */
const char TASK_Program_start_name[19] = "TASK_Program_start";
/* USER CODE END PFP */

/**
  * @brief  The application entry point.
  * @retval int
  */
int main(void)
{

  /* MCU Configuration--------------------------------------------------------*/

  /* Reset of all peripherals, Initializes the Flash interface and the Systick. */
  HAL_Init();

  /* Configure the system clock */
  SystemClock_Config();

  /* Initialize all configured peripherals */
  MX_GPIO_Init();
  MX_DMA_Init();
  MX_I2C3_Init();
  MX_SPI2_Init();
  MX_TIM2_Init();
  MX_TIM4_Init();
  MX_USART1_UART_Init();
  MX_ADC1_Init();
  MX_SPI1_Init();
  MX_TIM3_Init();
  MX_CRC_Init();
  MX_TIM11_Init();
  MX_TIM9_Init();
  MX_SPI3_Init();
  MX_USART6_UART_Init();
  /* USER CODE BEGIN 2 */

	MX_USB_DEVICE_Init();


#if (APEX_CFG_SCHED_SEQ == 1)
	DRIVERS_CONFIG_init_result_t Drivers_Init_Seq_result;
	DRIVERS_CONFIG_init_seq(&Drivers_Init_Seq_result);
	// Later on, we can implement more specific error handling based on the
	// type of failure. DRIVERS_CONFIG_init_seq could return different error codes for
	// different initialization failures or write on struct saying which module is
	// init and which isn't, etc. For now, we just do a generic error handler.

	setup();

#endif

#if (APEX_CFG_SCHED_RTOS == 1)
  /* USER CODE END 2 */

  /* Init scheduler */
  osKernelInitialize();  /* Call init function for freertos objects (in cmsis_os2.c) */
  MX_FREERTOS_Init();

  /* Start scheduler */
  osKernelStart();

  /* We should never get here as control is now taken by the scheduler */

  /* Infinite loop */
  /* USER CODE BEGIN WHILE */
#endif

	while (1) {
#if (APEX_CFG_SCHED_SEQ == 1)
		loop();
#endif
    /* USER CODE END WHILE */

    /* USER CODE BEGIN 3 */
	}
  /* USER CODE END 3 */
}

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
/**
  * @brief  Period elapsed callback in non blocking mode
  * @note   This function is called  when TIM10 interrupt took place, inside
  * HAL_TIM_IRQHandler(). It makes a direct call to HAL_IncTick() to increment
  * a global variable "uwTick" used as application time base.
  * @param  htim : TIM handle
  * @retval None
  */
void HAL_TIM_PeriodElapsedCallback(TIM_HandleTypeDef *htim)
{
  if (htim->Instance == TIM10)
  {
    HAL_IncTick();
  }
}

/**
  * @brief  This function is executed in case of error occurrence.
  * @retval None
  */
void Error_Handler(void)
{
  /* USER CODE BEGIN Error_Handler_Debug */
  /* User can add his own implementation to report the HAL error return state */
  __disable_irq();

  HAL_GPIO_TogglePin(LED0B_GPIO_Port, LED0B_Pin);
  while (1) {
  }
  /* USER CODE END Error_Handler_Debug */
}
#ifdef USE_FULL_ASSERT
/**
  * @brief  Reports the name of the source file and the source line number
  *         where the assert_param error has occurred.
  * @param  file: pointer to the source file name
  * @param  line: assert_param error line source number
  * @retval None
  */
void assert_failed(uint8_t *file, uint32_t line)
{
  /* USER CODE BEGIN 6 */
  /* User can add his own implementation to report the file name and line
     number, ex: printf("Wrong parameters value: file %s on line %d\r\n", file,
     line) */
	while (1);
  /* USER CODE END 6 */
}
#endif /* USE_FULL_ASSERT */
