povdoigt/Apex/KODE/APEX_NO_GPS/APEX_NO_GPS.ioc

Mcu.UserName=STM32F411RETx
PA0-WKUP.GPIO_Label=LED0G
PA0-WKUP.Signal=S_TIM2_CH1_ETR
PA1.GPIO_Label=LED0B
PA1.Signal=S_TIM2_CH2
PA11.Signal=USB_OTG_FS_DM
PA12.Signal=USB_OTG_FS_DP
PA13.Signal=SYS_JTMS-SWDIO
PA14.Signal=SYS_JTCK-SWCLK
PA15.GPIO_Label=LORA_DIO0
PA15.Signal=GPIO_Input
PA2.GPIO_Label=LED0R
PA2.Signal=S_TIM2_CH3
PA3.GPIO_Label=CS_ACC1
PA3.Signal=GPIO_Output
PA4.GPIO_Label=CS_ACC0
PA4.Signal=GPIO_Output
PA5.Signal=SPI1_SCK
PA6.Signal=SPI1_MISO
PA7.Signal=SPI1_MOSI
PA8.Signal=I2C3_SCL
PB0.GPIO_Label=SENCE_BAT
PB0.Signal=ADCx_IN8
PB1.GPIO_Label=BUZZER
PB1.Signal=S_TIM3_CH4
PB10.Signal=SPI2_SCK
PB2.GPIO_Label=CS_GRYO
PB2.Signal=GPIO_Output
PB6.GPIO_Label=LED1G
PB6.Signal=S_TIM4_CH1
PB7.GPIO_Label=LED1B
PB7.Signal=S_TIM4_CH2
PB8.GPIO_Label=LED1R
PB8.Signal=S_TIM4_CH3
PC0.GPIO_Label=RESET_GPS
PC0.Signal=GPIO_Output
PC1.GPIO_Label=CS_FLASH
PC1.Signal=GPIO_Output
PC14-OSC32_IN.Signal=RCC_OSC32_IN
PC15-OSC32_OUT.Signal=RCC_OSC32_OUT
PC2.Signal=SPI2_MISO
PC3.Signal=SPI2_MOSI
PC4.GPIO_Label=CS_LORA
PC4.Signal=GPIO_Output
PC5.GPIO_Label=RESET_LORA
PC5.Signal=GPIO_Output
PC9.Signal=I2C3_SDA
