povdoigt/Apex/KODE/APEX_v1_1/Core/Inc/main.h

#define RESET_GPS_Pin GPIO_PIN_0
#define RESET_GPS_GPIO_Port GPIOC
#define CS_FLASH_Pin GPIO_PIN_1
#define CS_FLASH_GPIO_Port GPIOC
#define LED0G_Pin GPIO_PIN_0
#define LED0G_GPIO_Port GPIOA
#define LED0B_Pin GPIO_PIN_1
#define LED0B_GPIO_Port GPIOA
#define LED0R_Pin GPIO_PIN_2
#define LED0R_GPIO_Port GPIOA
#define CS_ACC1_Pin GPIO_PIN_3
#define CS_ACC1_GPIO_Port GPIOA
#define CS_ACC0_Pin GPIO_PIN_4
#define CS_ACC0_GPIO_Port GPIOA
#define CS_LORA_Pin GPIO_PIN_4
#define CS_LORA_GPIO_Port GPIOC
#define RESET_LORA_Pin GPIO_PIN_5
#define RESET_LORA_GPIO_Port GPIOC
#define SENCE_BAT_Pin GPIO_PIN_0
#define SENCE_BAT_GPIO_Port GPIOB
#define BUZZER_Pin GPIO_PIN_1
#define BUZZER_GPIO_Port GPIOB
#define CS_GYRO_Pin GPIO_PIN_2
#define CS_GYRO_GPIO_Port GPIOB
#define UART_SEL_Pin GPIO_PIN_15
#define UART_SEL_GPIO_Port GPIOB
#define LORA_DIO0_Pin GPIO_PIN_15
#define LORA_DIO0_GPIO_Port GPIOA
#define SPI3_CS_Pin GPIO_PIN_2
#define SPI3_CS_GPIO_Port GPIOD
#define GFSK_NRST_Pin GPIO_PIN_3
#define GFSK_NRST_GPIO_Port GPIOB
#define SEQ_DA_Pin GPIO_PIN_5
#define SEQ_DA_GPIO_Port GPIOB
#define LED1G_Pin GPIO_PIN_6
#define LED1G_GPIO_Port GPIOB
#define LED1B_Pin GPIO_PIN_7
#define LED1B_GPIO_Port GPIOB
#define LED1R_Pin GPIO_PIN_8
#define LED1R_GPIO_Port GPIOB
#define CAM_Pin GPIO_PIN_9
#define CAM_GPIO_Port GPIOB
