povdoigt/Apex/KODE/APEX_v1_1/Core/Src/tim.c

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
/* Includes ------------------------------------------------------------------*/
#include "tim.h"

TIM_HandleTypeDef htim2;
TIM_HandleTypeDef htim3;
TIM_HandleTypeDef htim4;
TIM_HandleTypeDef htim9;
TIM_HandleTypeDef htim11;

/* TIM2 init function */
void MX_TIM2_Init(void)
{

  TIM_ClockConfigTypeDef sClockSourceConfig = {0};
  TIM_MasterConfigTypeDef sMasterConfig = {0};
  TIM_OC_InitTypeDef sConfigOC = {0};

  htim2.Instance = TIM2;
  htim2.Init.Prescaler = 0;
  htim2.Init.CounterMode = TIM_COUNTERMODE_UP;
  htim2.Init.Period = 65535;
  htim2.Init.ClockDivision = TIM_CLOCKDIVISION_DIV1;
  htim2.Init.AutoReloadPreload = TIM_AUTORELOAD_PRELOAD_DISABLE;
  if (HAL_TIM_Base_Init(&htim2) != HAL_OK)
  {
    Error_Handler();
  }
  sClockSourceConfig.ClockSource = TIM_CLOCKSOURCE_INTERNAL;
  if (HAL_TIM_ConfigClockSource(&htim2, &sClockSourceConfig) != HAL_OK)
  {
    Error_Handler();
  }
  if (HAL_TIM_PWM_Init(&htim2) != HAL_OK)
  {
    Error_Handler();
  }
  sMasterConfig.MasterOutputTrigger = TIM_TRGO_RESET;
  sMasterConfig.MasterSlaveMode = TIM_MASTERSLAVEMODE_DISABLE;
  if (HAL_TIMEx_MasterConfigSynchronization(&htim2, &sMasterConfig) != HAL_OK)
  {
    Error_Handler();
  }
  sConfigOC.OCMode = TIM_OCMODE_PWM1;
  sConfigOC.Pulse = 0;
  sConfigOC.OCPolarity = TIM_OCPOLARITY_HIGH;
  sConfigOC.OCFastMode = TIM_OCFAST_DISABLE;
  if (HAL_TIM_PWM_ConfigChannel(&htim2, &sConfigOC, TIM_CHANNEL_1) != HAL_OK)
  {
    Error_Handler();
  }
  if (HAL_TIM_PWM_ConfigChannel(&htim2, &sConfigOC, TIM_CHANNEL_2) != HAL_OK)
  {
    Error_Handler();
  }
  if (HAL_TIM_PWM_ConfigChannel(&htim2, &sConfigOC, TIM_CHANNEL_3) != HAL_OK)
  {
    Error_Handler();
  }
  HAL_TIM_MspPostInit(&htim2);

}
/* TIM3 init function */
void MX_TIM3_Init(void)
{

  TIM_ClockConfigTypeDef sClockSourceConfig = {0};
  TIM_MasterConfigTypeDef sMasterConfig = {0};
  TIM_OC_InitTypeDef sConfigOC = {0};

  htim3.Instance = TIM3;
  htim3.Init.Prescaler = 0;
  htim3.Init.CounterMode = TIM_COUNTERMODE_UP;
  htim3.Init.Period = 65535;
  htim3.Init.ClockDivision = TIM_CLOCKDIVISION_DIV1;
  htim3.Init.AutoReloadPreload = TIM_AUTORELOAD_PRELOAD_DISABLE;
  if (HAL_TIM_Base_Init(&htim3) != HAL_OK)
  {
    Error_Handler();
  }
  sClockSourceConfig.ClockSource = TIM_CLOCKSOURCE_INTERNAL;
  if (HAL_TIM_ConfigClockSource(&htim3, &sClockSourceConfig) != HAL_OK)
  {
    Error_Handler();
  }
  if (HAL_TIM_PWM_Init(&htim3) != HAL_OK)
  {
    Error_Handler();
  }
  sMasterConfig.MasterOutputTrigger = TIM_TRGO_RESET;
  sMasterConfig.MasterSlaveMode = TIM_MASTERSLAVEMODE_DISABLE;
  if (HAL_TIMEx_MasterConfigSynchronization(&htim3, &sMasterConfig) != HAL_OK)
  {
    Error_Handler();
  }
  sConfigOC.OCMode = TIM_OCMODE_PWM1;
  sConfigOC.Pulse = 0;
  sConfigOC.OCPolarity = TIM_OCPOLARITY_HIGH;
  sConfigOC.OCFastMode = TIM_OCFAST_DISABLE;
  if (HAL_TIM_PWM_ConfigChannel(&htim3, &sConfigOC, TIM_CHANNEL_4) != HAL_OK)
  {
    Error_Handler();
  }
  HAL_TIM_MspPostInit(&htim3);

}
/* TIM4 init function */
void MX_TIM4_Init(void)
{

  TIM_ClockConfigTypeDef sClockSourceConfig = {0};
  TIM_MasterConfigTypeDef sMasterConfig = {0};
  TIM_OC_InitTypeDef sConfigOC = {0};

  htim4.Instance = TIM4;
  htim4.Init.Prescaler = 0;
  htim4.Init.CounterMode = TIM_COUNTERMODE_UP;
  htim4.Init.Period = 65535;
  htim4.Init.ClockDivision = TIM_CLOCKDIVISION_DIV1;
  htim4.Init.AutoReloadPreload = TIM_AUTORELOAD_PRELOAD_DISABLE;
  if (HAL_TIM_Base_Init(&htim4) != HAL_OK)
  {
    Error_Handler();
  }
  sClockSourceConfig.ClockSource = TIM_CLOCKSOURCE_INTERNAL;
  if (HAL_TIM_ConfigClockSource(&htim4, &sClockSourceConfig) != HAL_OK)
  {
    Error_Handler();
  }
  if (HAL_TIM_PWM_Init(&htim4) != HAL_OK)
  {
    Error_Handler();
  }
  sMasterConfig.MasterOutputTrigger = TIM_TRGO_RESET;
  sMasterConfig.MasterSlaveMode = TIM_MASTERSLAVEMODE_DISABLE;
  if (HAL_TIMEx_MasterConfigSynchronization(&htim4, &sMasterConfig) != HAL_OK)
  {
    Error_Handler();
  }
  sConfigOC.OCMode = TIM_OCMODE_PWM1;
  sConfigOC.Pulse = 0;
  sConfigOC.OCPolarity = TIM_OCPOLARITY_HIGH;
  sConfigOC.OCFastMode = TIM_OCFAST_DISABLE;
  if (HAL_TIM_PWM_ConfigChannel(&htim4, &sConfigOC, TIM_CHANNEL_1) != HAL_OK)
  {
    Error_Handler();
  }
  if (HAL_TIM_PWM_ConfigChannel(&htim4, &sConfigOC, TIM_CHANNEL_2) != HAL_OK)
  {
    Error_Handler();
  }
  if (HAL_TIM_PWM_ConfigChannel(&htim4, &sConfigOC, TIM_CHANNEL_3) != HAL_OK)
  {
    Error_Handler();
  }
  HAL_TIM_MspPostInit(&htim4);

}
/* TIM9 init function */
void MX_TIM9_Init(void)
{

  TIM_ClockConfigTypeDef sClockSourceConfig = {0};

  htim9.Instance = TIM9;
  htim9.Init.Prescaler = 1-1;
  htim9.Init.CounterMode = TIM_COUNTERMODE_UP;
  htim9.Init.Period = 65535-1;
  htim9.Init.ClockDivision = TIM_CLOCKDIVISION_DIV1;
  htim9.Init.AutoReloadPreload = TIM_AUTORELOAD_PRELOAD_DISABLE;
  if (HAL_TIM_Base_Init(&htim9) != HAL_OK)
  {
    Error_Handler();
  }
  sClockSourceConfig.ClockSource = TIM_CLOCKSOURCE_INTERNAL;
  if (HAL_TIM_ConfigClockSource(&htim9, &sClockSourceConfig) != HAL_OK)
  {
    Error_Handler();
  }
  /* USER CODE BEGIN TIM9_Init 2 */
  uint32_t pclk2_freq = HAL_RCC_GetPCLK2Freq();
  uint32_t prescale = pclk2_freq / 1000000 - 1; // 1 MHz timer frequency
  __HAL_TIM_SET_PRESCALER(&htim9, prescale);
  /* USER CODE END TIM9_Init 2 */

}
/* TIM11 init function */
void MX_TIM11_Init(void)
{

  htim11.Instance = TIM11;
  htim11.Init.Prescaler = 0;
  htim11.Init.CounterMode = TIM_COUNTERMODE_UP;
  htim11.Init.Period = 65535;
  htim11.Init.ClockDivision = TIM_CLOCKDIVISION_DIV1;
  htim11.Init.AutoReloadPreload = TIM_AUTORELOAD_PRELOAD_DISABLE;
  if (HAL_TIM_Base_Init(&htim11) != HAL_OK)
  {
    Error_Handler();
  }
}

void HAL_TIM_Base_MspInit(TIM_HandleTypeDef* tim_baseHandle)
{

  if(tim_baseHandle->Instance==TIM2)
  {
    /* TIM2 clock enable */
    __HAL_RCC_TIM2_CLK_ENABLE();
  }
  else if(tim_baseHandle->Instance==TIM3)
  {
    /* TIM3 clock enable */
    __HAL_RCC_TIM3_CLK_ENABLE();
  }
  else if(tim_baseHandle->Instance==TIM4)
  {
    /* TIM4 clock enable */
    __HAL_RCC_TIM4_CLK_ENABLE();
  }
  else if(tim_baseHandle->Instance==TIM9)
  {
    /* TIM9 clock enable */
    __HAL_RCC_TIM9_CLK_ENABLE();
  }
  else if(tim_baseHandle->Instance==TIM11)
  {
    /* TIM11 clock enable */
    __HAL_RCC_TIM11_CLK_ENABLE();

    /* TIM11 interrupt Init */
    HAL_NVIC_SetPriority(TIM1_TRG_COM_TIM11_IRQn, 5, 0);
    HAL_NVIC_EnableIRQ(TIM1_TRG_COM_TIM11_IRQn);
  }
}
void HAL_TIM_MspPostInit(TIM_HandleTypeDef* timHandle)
{

  GPIO_InitTypeDef GPIO_InitStruct = {0};
  if(timHandle->Instance==TIM2)
  {
    __HAL_RCC_GPIOA_CLK_ENABLE();
    /**TIM2 GPIO Configuration
    PA0-WKUP     ------> TIM2_CH1
    PA1     ------> TIM2_CH2
    PA2     ------> TIM2_CH3
    */
    GPIO_InitStruct.Pin = LED0G_Pin|LED0B_Pin|LED0R_Pin;
    GPIO_InitStruct.Mode = GPIO_MODE_AF_PP;
    GPIO_InitStruct.Pull = GPIO_NOPULL;
    GPIO_InitStruct.Speed = GPIO_SPEED_FREQ_LOW;
    GPIO_InitStruct.Alternate = GPIO_AF1_TIM2;
    HAL_GPIO_Init(GPIOA, &GPIO_InitStruct);

  }
  else if(timHandle->Instance==TIM3)
  {
    __HAL_RCC_GPIOB_CLK_ENABLE();
    /**TIM3 GPIO Configuration
    PB1     ------> TIM3_CH4
    */
    GPIO_InitStruct.Pin = BUZZER_Pin;
    GPIO_InitStruct.Mode = GPIO_MODE_AF_PP;
    GPIO_InitStruct.Pull = GPIO_NOPULL;
    GPIO_InitStruct.Speed = GPIO_SPEED_FREQ_LOW;
    GPIO_InitStruct.Alternate = GPIO_AF2_TIM3;
    HAL_GPIO_Init(BUZZER_GPIO_Port, &GPIO_InitStruct);

  }
  else if(timHandle->Instance==TIM4)
  {
    __HAL_RCC_GPIOB_CLK_ENABLE();
    /**TIM4 GPIO Configuration
    PB6     ------> TIM4_CH1
    PB7     ------> TIM4_CH2
    PB8     ------> TIM4_CH3
    */
    GPIO_InitStruct.Pin = LED1G_Pin|LED1B_Pin|LED1R_Pin;
    GPIO_InitStruct.Mode = GPIO_MODE_AF_PP;
    GPIO_InitStruct.Pull = GPIO_NOPULL;
    GPIO_InitStruct.Speed = GPIO_SPEED_FREQ_LOW;
    GPIO_InitStruct.Alternate = GPIO_AF2_TIM4;
    HAL_GPIO_Init(GPIOB, &GPIO_InitStruct);

  }

}

void HAL_TIM_Base_MspDeInit(TIM_HandleTypeDef* tim_baseHandle)
{

  if(tim_baseHandle->Instance==TIM2)
  {
    /* Peripheral clock disable */
    __HAL_RCC_TIM2_CLK_DISABLE();
  }
  else if(tim_baseHandle->Instance==TIM3)
  {
    /* Peripheral clock disable */
    __HAL_RCC_TIM3_CLK_DISABLE();
  }
  else if(tim_baseHandle->Instance==TIM4)
  {
    /* Peripheral clock disable */
    __HAL_RCC_TIM4_CLK_DISABLE();
  }
  else if(tim_baseHandle->Instance==TIM9)
  {
    /* Peripheral clock disable */
    __HAL_RCC_TIM9_CLK_DISABLE();
  }
  else if(tim_baseHandle->Instance==TIM11)
  {
    /* Peripheral clock disable */
    __HAL_RCC_TIM11_CLK_DISABLE();

    /* TIM11 interrupt Deinit */
    HAL_NVIC_DisableIRQ(TIM1_TRG_COM_TIM11_IRQn);
  }
}

/* USER CODE BEGIN 1 */

uint32_t TIM_get_timer_frequency(TIM_HandleTypeDef* htim) {
	#ifdef TIM1
	if (htim->Instance == TIM1) {
		return HAL_RCC_GetPCLK2Freq();
	}
	#endif // TIM1
	#ifdef TIM2
	if (htim->Instance == TIM2) {
		return HAL_RCC_GetPCLK1Freq();
	}
	#endif // TIM2
	#ifdef TIM3
	if (htim->Instance == TIM3) {
		return HAL_RCC_GetPCLK1Freq();
	}
	#endif // TIM3
	#ifdef TIM4
	if (htim->Instance == TIM4) {
		return HAL_RCC_GetPCLK1Freq();
	}
	#endif // TIM4
	#ifdef TIM5
	if (htim->Instance == TIM5) {
		return HAL_RCC_GetPCLK1Freq();
	}
	#endif // TIM5
	#ifdef TIM9
	if (htim->Instance == TIM9) {
		return HAL_RCC_GetPCLK2Freq();
	}
	#endif // TIM9
	#ifdef TIM10
	if (htim->Instance == TIM10) {
		return HAL_RCC_GetPCLK2Freq();
	}
	#endif // TIM10
	#ifdef TIM11
	if (htim->Instance == TIM11) {
		return HAL_RCC_GetPCLK2Freq();
	}
	#endif // TIM11
	return 0; // Error: Timer not found
}

void TIM_set_frequency(TIM_HandleTypeDef* htim, float freq) {
	uint32_t timer_freq = TIM_get_timer_frequency(htim);
	uint32_t periode = htim->Init.Period;
  float max_freq = (float)timer_freq / (float)(periode + 1);
	if (freq == 0 || (freq >= max_freq)) {
    return; // Frequency too high or zero, no change
  }else {
    // Equation : freq = timer_freq / ((prescaler + 1) * (periode + 1))
		uint32_t prescaler = (uint32_t)(max_freq / freq) - 1;
	  __HAL_TIM_SET_PRESCALER(htim, prescaler);
	}
}

/* USER CODE END 1 */
