povdoigt/Apex/KODE/APEX_v1_1/Core/Src/usart.c

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
/* Includes ------------------------------------------------------------------*/
#include "usart.h"

/* USER CODE BEGIN 0 */
#include "drivers_config.h"
#include "project.h"

#include "uart_mux.h"
#include "WT901B.h"
#include "event_uart.h"

#include "usbd_cdc_if.h"
/* USER CODE END 0 */

UART_HandleTypeDef huart1;
UART_HandleTypeDef huart6;
DMA_HandleTypeDef hdma_usart1_rx;
DMA_HandleTypeDef hdma_usart1_tx;
DMA_HandleTypeDef hdma_usart6_rx;
DMA_HandleTypeDef hdma_usart6_tx;

/* USART1 init function */

void MX_USART1_UART_Init(void)
{

  huart1.Instance = USART1;
  huart1.Init.BaudRate = 9600;
  huart1.Init.WordLength = UART_WORDLENGTH_8B;
  huart1.Init.StopBits = UART_STOPBITS_1;
  huart1.Init.Parity = UART_PARITY_NONE;
  huart1.Init.Mode = UART_MODE_TX_RX;
  huart1.Init.HwFlowCtl = UART_HWCONTROL_NONE;
  huart1.Init.OverSampling = UART_OVERSAMPLING_16;
  if (HAL_UART_Init(&huart1) != HAL_OK)
  {
    Error_Handler();
  }
}
/* USART6 init function */

void MX_USART6_UART_Init(void)
{

  huart6.Instance = USART6;
  huart6.Init.BaudRate = 115200;
  huart6.Init.WordLength = UART_WORDLENGTH_8B;
  huart6.Init.StopBits = UART_STOPBITS_1;
  huart6.Init.Parity = UART_PARITY_NONE;
  huart6.Init.Mode = UART_MODE_TX_RX;
  huart6.Init.HwFlowCtl = UART_HWCONTROL_NONE;
  huart6.Init.OverSampling = UART_OVERSAMPLING_16;
  if (HAL_UART_Init(&huart6) != HAL_OK)
  {
    Error_Handler();
  }
}

void HAL_UART_MspInit(UART_HandleTypeDef* uartHandle)
{

  GPIO_InitTypeDef GPIO_InitStruct = {0};
  if(uartHandle->Instance==USART1)
  {
    /* USART1 clock enable */
    __HAL_RCC_USART1_CLK_ENABLE();

    __HAL_RCC_GPIOA_CLK_ENABLE();
    /**USART1 GPIO Configuration
    PA9     ------> USART1_TX
    PA10     ------> USART1_RX
    */
    GPIO_InitStruct.Pin = GPIO_PIN_9|GPIO_PIN_10;
    GPIO_InitStruct.Mode = GPIO_MODE_AF_PP;
    GPIO_InitStruct.Pull = GPIO_NOPULL;
    GPIO_InitStruct.Speed = GPIO_SPEED_FREQ_VERY_HIGH;
    GPIO_InitStruct.Alternate = GPIO_AF7_USART1;
    HAL_GPIO_Init(GPIOA, &GPIO_InitStruct);

    /* USART1 DMA Init */
    /* USART1_RX Init */
    hdma_usart1_rx.Instance = DMA2_Stream5;
    hdma_usart1_rx.Init.Channel = DMA_CHANNEL_4;
    hdma_usart1_rx.Init.Direction = DMA_PERIPH_TO_MEMORY;
    hdma_usart1_rx.Init.PeriphInc = DMA_PINC_DISABLE;
    hdma_usart1_rx.Init.MemInc = DMA_MINC_ENABLE;
    hdma_usart1_rx.Init.PeriphDataAlignment = DMA_PDATAALIGN_BYTE;
    hdma_usart1_rx.Init.MemDataAlignment = DMA_MDATAALIGN_BYTE;
    hdma_usart1_rx.Init.Mode = DMA_NORMAL;
    hdma_usart1_rx.Init.Priority = DMA_PRIORITY_LOW;
    hdma_usart1_rx.Init.FIFOMode = DMA_FIFOMODE_DISABLE;
    if (HAL_DMA_Init(&hdma_usart1_rx) != HAL_OK)
    {
      Error_Handler();
    }

    __HAL_LINKDMA(uartHandle,hdmarx,hdma_usart1_rx);

    /* USART1_TX Init */
    hdma_usart1_tx.Instance = DMA2_Stream7;
    hdma_usart1_tx.Init.Channel = DMA_CHANNEL_4;
    hdma_usart1_tx.Init.Direction = DMA_MEMORY_TO_PERIPH;
    hdma_usart1_tx.Init.PeriphInc = DMA_PINC_DISABLE;
    hdma_usart1_tx.Init.MemInc = DMA_MINC_ENABLE;
    hdma_usart1_tx.Init.PeriphDataAlignment = DMA_PDATAALIGN_BYTE;
    hdma_usart1_tx.Init.MemDataAlignment = DMA_MDATAALIGN_BYTE;
    hdma_usart1_tx.Init.Mode = DMA_NORMAL;
    hdma_usart1_tx.Init.Priority = DMA_PRIORITY_LOW;
    hdma_usart1_tx.Init.FIFOMode = DMA_FIFOMODE_DISABLE;
    if (HAL_DMA_Init(&hdma_usart1_tx) != HAL_OK)
    {
      Error_Handler();
    }

    __HAL_LINKDMA(uartHandle,hdmatx,hdma_usart1_tx);

    /* USART1 interrupt Init */
    HAL_NVIC_SetPriority(USART1_IRQn, 5, 0);
    HAL_NVIC_EnableIRQ(USART1_IRQn);
  }
  else if(uartHandle->Instance==USART6)
  {
    /* USART6 clock enable */
    __HAL_RCC_USART6_CLK_ENABLE();

    __HAL_RCC_GPIOC_CLK_ENABLE();
    /**USART6 GPIO Configuration
    PC6     ------> USART6_TX
    PC7     ------> USART6_RX
    */
    GPIO_InitStruct.Pin = GPIO_PIN_6|GPIO_PIN_7;
    GPIO_InitStruct.Mode = GPIO_MODE_AF_PP;
    GPIO_InitStruct.Pull = GPIO_NOPULL;
    GPIO_InitStruct.Speed = GPIO_SPEED_FREQ_VERY_HIGH;
    GPIO_InitStruct.Alternate = GPIO_AF8_USART6;
    HAL_GPIO_Init(GPIOC, &GPIO_InitStruct);

    /* USART6 DMA Init */
    /* USART6_RX Init */
    hdma_usart6_rx.Instance = DMA2_Stream1;
    hdma_usart6_rx.Init.Channel = DMA_CHANNEL_5;
    hdma_usart6_rx.Init.Direction = DMA_PERIPH_TO_MEMORY;
    hdma_usart6_rx.Init.PeriphInc = DMA_PINC_DISABLE;
    hdma_usart6_rx.Init.MemInc = DMA_MINC_ENABLE;
    hdma_usart6_rx.Init.PeriphDataAlignment = DMA_PDATAALIGN_BYTE;
    hdma_usart6_rx.Init.MemDataAlignment = DMA_MDATAALIGN_BYTE;
    hdma_usart6_rx.Init.Mode = DMA_NORMAL;
    hdma_usart6_rx.Init.Priority = DMA_PRIORITY_LOW;
    hdma_usart6_rx.Init.FIFOMode = DMA_FIFOMODE_DISABLE;
    if (HAL_DMA_Init(&hdma_usart6_rx) != HAL_OK)
    {
      Error_Handler();
    }

    __HAL_LINKDMA(uartHandle,hdmarx,hdma_usart6_rx);

    /* USART6_TX Init */
    hdma_usart6_tx.Instance = DMA2_Stream6;
    hdma_usart6_tx.Init.Channel = DMA_CHANNEL_5;
    hdma_usart6_tx.Init.Direction = DMA_MEMORY_TO_PERIPH;
    hdma_usart6_tx.Init.PeriphInc = DMA_PINC_DISABLE;
    hdma_usart6_tx.Init.MemInc = DMA_MINC_ENABLE;
    hdma_usart6_tx.Init.PeriphDataAlignment = DMA_PDATAALIGN_BYTE;
    hdma_usart6_tx.Init.MemDataAlignment = DMA_MDATAALIGN_BYTE;
    hdma_usart6_tx.Init.Mode = DMA_NORMAL;
    hdma_usart6_tx.Init.Priority = DMA_PRIORITY_LOW;
    hdma_usart6_tx.Init.FIFOMode = DMA_FIFOMODE_DISABLE;
    if (HAL_DMA_Init(&hdma_usart6_tx) != HAL_OK)
    {
      Error_Handler();
    }

    __HAL_LINKDMA(uartHandle,hdmatx,hdma_usart6_tx);

    /* USART6 interrupt Init */
    HAL_NVIC_SetPriority(USART6_IRQn, 5, 0);
    HAL_NVIC_EnableIRQ(USART6_IRQn);
  }
}

void HAL_UART_MspDeInit(UART_HandleTypeDef* uartHandle)
{

  if(uartHandle->Instance==USART1)
  {
    /* Peripheral clock disable */
    __HAL_RCC_USART1_CLK_DISABLE();

    /**USART1 GPIO Configuration
    PA9     ------> USART1_TX
    PA10     ------> USART1_RX
    */
    HAL_GPIO_DeInit(GPIOA, GPIO_PIN_9|GPIO_PIN_10);

    /* USART1 DMA DeInit */
    HAL_DMA_DeInit(uartHandle->hdmarx);
    HAL_DMA_DeInit(uartHandle->hdmatx);

    /* USART1 interrupt Deinit */
    HAL_NVIC_DisableIRQ(USART1_IRQn);
  }
  else if(uartHandle->Instance==USART6)
  {
    /* Peripheral clock disable */
    __HAL_RCC_USART6_CLK_DISABLE();

    /**USART6 GPIO Configuration
    PC6     ------> USART6_TX
    PC7     ------> USART6_RX
    */
    HAL_GPIO_DeInit(GPIOC, GPIO_PIN_6|GPIO_PIN_7);

    /* USART6 DMA DeInit */
    HAL_DMA_DeInit(uartHandle->hdmarx);
    HAL_DMA_DeInit(uartHandle->hdmatx);

    /* USART6 interrupt Deinit */
    HAL_NVIC_DisableIRQ(USART6_IRQn);
  }
}

/* USER CODE BEGIN 1 */

#ifdef USART1
  UART_buffer_t uart_buffer_1 = { 0 };
#endif
#ifdef USART2
  UART_buffer_t uart_buffer_2 = { 0 };
#endif
#ifdef USART3
  UART_buffer_t uart_buffer_3 = { 0 };
#endif
#ifdef UART4
  UART_buffer_t uart_buffer_4 = { 0 };
#endif
#ifdef UART5
  UART_buffer_t uart_buffer_5 = { 0 };
#endif
#ifdef USART6
  UART_buffer_t uart_buffer_6 = { 0 };
#endif

UART_buffer_t *UART_buffer_init(UART_HandleTypeDef *huart, uint8_t *buffer, size_t length) {
  UART_buffer_t *uart_buffer = UART_buffer_get(huart);
  if (uart_buffer == NULL) {
    return NULL; // Unknown UART instance
  }
  uart_buffer->rx_buffer = buffer;
  uart_buffer->rx_length = length;
  return uart_buffer;
}

UART_buffer_t *UART_buffer_get(UART_HandleTypeDef *huart) {
#ifdef USART1
  if (huart->Instance == USART1) {
    return &uart_buffer_1;
  }
#endif
#ifdef USART2
  if (huart->Instance == USART2) {
    return &uart_buffer_2;
  } else
#endif
#ifdef USART3
  if (huart->Instance == USART3) {
    return &uart_buffer_3;
  } else
#endif
#ifdef UART4
  if (huart->Instance == UART4) {
    return &uart_buffer_4;
  } else
#endif
#ifdef UART5
  if (huart->Instance == UART5) {
    return &uart_buffer_5;
  } else
#endif
#ifdef USART6
  if (huart->Instance == USART6) {
    return &uart_buffer_6;
  } else
#endif
  {
    return NULL; // Unknown UART instance
  }
}

// void HAL_UARTEx_RxEventCallback(UART_HandleTypeDef *huart, uint16_t Size) {
//   if (huart->Instance == USART6) {
//     switch (uart_mux_get_channel(&uart_mux)) {
//       case UART_MUX_CHANNEL_0:
//         WT901B_UART_Callback_RX_IRQHandler(&wt901b, Size);
//         break;
//       case UART_MUX_CHANNEL_1:
//         event_uart_consumer_callback(Size);
//         break;
//       default:
//         break;
//     }
//   }

//   UART_buffer_t *uart_buffer = UART_buffer_get(huart);
//   if (uart_buffer != NULL) {
//     if (uart_buffer->rx_buffer != NULL && uart_buffer->rx_length > 0) {
//       HAL_UARTEx_ReceiveToIdle_IT(huart, uart_buffer->rx_buffer, uart_buffer->rx_length);
//     }
//   }
// }

/* USER CODE END 1 */
