povdoigt/Apex/(commit log)

2024-10-31 Test de qt
2025-02-13 Add Uart Test
2025-10-19 Refactor data handling: replace data_publisher with data_topic, update circular buffer and data_topic implementation
    [BMI088.h, LSM303AGR.h, main.c]
2025-10-22 Enhance circular buffer and data topic: add mutex for thread-safe access and improve locking mechanisms
2025-10-24 Corrige la fonction data_topic_init et implémente la fonction data_sub_num_to_read
    [BMI088.c, BMI088.h, main.c, main.h]
2025-10-24 Enlevé la freelist pour TASK_POOL_OBJ
2025-10-24 Ajout d'une liste chainé dans topic pour lister les subs
2025-10-24 Renomme les structures de données pour une meilleure clarté : circular_buffer_t et data_topic_t
2025-10-25 Ajout d'un sémaphore pour le call-back dans la structure data_sub_t, test de ce dernier, noms des sémaphores/mutex déjà testé enlevé, Changelnet de configuration de FreeRTOS pour permettre un log tem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
2025-10-25 Ajout d'un sémaphore pour le call-back dans la structure data_sub_t, test de ce dernier, noms des sémaphores/mutex déjà testé enlevé, Changelnet de configuration de FreeRTOS pour permettre un log tem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
2025-10-26 Refactor W25Q memory driver and main application
    - Updated W25Q memory driver to improve state management and error handling.
    - Changed function signatures to return W25Q_STATE for better error tracking.
    - Added support for reading, writing, and erasing data with improved buffer management.
    - Change main to test sequential erase / read / write operation.
    - Removed commented-out code and unnecessary variables for cleaner implementation.
    - Enhanced memory operations to handle larger data sizes and ensure data integrity.
    - Need to testit on all the memory somehow to ensure data integrity.
    [main.c, main.h]
2025-10-27 Fixe de quelques problèmes
    [main.c]
2025-10-29 Refactor W25Q initialization and erase commands
    - Updated W25Q_Init function calls to remove unnecessary parameters in main.c and test.c.
    - Replaced W25Q_EraseSector calls with W25Q_SendCmdAddr for sector erase in main.c.
    - Add FreeRTOS implementation
    [main.c, test.c]
2025-11-01 Ajout d'une version TASK des fonctions de niveau 1 RTOS. (utilse pôur par exemple lancer un Therad "Erase Chip")
2025-11-02 Refactor W25Q memory driver and add read/write test functionality
    - Updated scheduler.h to include a memory pool block in task pool object declaration.
    - Enhanced w25q_mem.c with semaphore management for thread safety during SPI transactions.
    - Implemented a read/write test for W25Q flash memory to verify data integrity after operations.
2025-11-02 Refonte de la mentalité des fonctions SPI pour permettre une utilisation plus simple des fonctions W25Q_Read et W25Q_Write. Suppression des dummy bytes
2025-11-03 Fix RFM96 PA ramp definition, update TASK pool size, and enhance USB watchdog functions, Correct new SPI RTOS function for BMI088
    [BMI088.c, main.c, main.h, test.c]
2025-11-05 Refactor main.c: Initialize W25Q chip and manage USB connection with LED indication
    - Reintroduced W25Q chip initialization and state assertion.
    - Added USB connection management with LED blinking to indicate status.
    - Implemented data reading from W25Q chip and transmitting via CDC.
    - Cleaned up commented-out code for better readability and maintainability.
2025-11-05 Refactor W25Q driver: Rename W25Q_Chip to W25Q_t for consistency and clarity in function signatures
2025-11-05 Add BMI088 driver header and improve ADXL375 SPI communication
    - Introduced a new header file for the BMI088 driver, detailing API levels and return codes.
    - Defined output units for acceleration and gyroscope in the BMI088 header.
    - Enhanced the ADXL375 driver by including necessary STM32 HAL headers.
    - Modified the ADXL375 initialization function to ensure proper SPI configuration.
    - Updated the ADXL375_ReadRegister function to configure SPI settings before communication and restore them afterward.
2025-11-07 Refactor W25Q memory driver and update type definitions
    - Removed unused inline function declarations in w25q_mem.h for cleaner code.
    - Changed the struct name from FLOAT3 to float3_t in types.h for consistency with naming conventions.
    - Updated the BMI088_Init function to use the new bmi088_t type instead of the old BMI088 type, ensuring better type safety and clarity.
2025-11-08 Refactor and update various components in the APEX project
    - Removed unnecessary includes from w25q_mem.c and main.c.
    - Updated data types for BMI088 and W25Q structures in main.c and related files.
    - Added initialization function for TIM9 in tim.c, including clock configuration and MSP functions.
    - Implemented a microsecond delay function using TIM9 in tools.c.
    - Updated flash_stream.c to use the new W25Q_t type.
    - Modified test.c to accommodate changes in BMI088 and W25Q types.
    - Updated HAL driver version to 1.8.5 in stm32f4xx_hal.c.
    - Initialized FLASH_ProcessTypeDef with default values in stm32f4xx_hal_flash.c.
    - Corrected context checks in HAL_MMC_IRQHandler in stm32f4xx_hal_mmc.c.
    - C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
    [APEX_v1_0.ioc, BMI088.c, BMI088.h, main.c, test.c]
2025-11-08 Fix type definitions in BMI088 driver structure for accelerometer and gyroscope ranges
    [BMI088.h]
2025-11-08 Enhance BMI088 driver with RTOS support and add semaphore management; refactor function signatures for consistency
2025-11-09 Enhance BMI088 driver with RTOS support, refactor task argument structures, and update semaphore management; fix type definitions for GPIO pins and improve temperature and acceleration data handling;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
    [BMI088.c, BMI088.h, main.c, main.h, tools.c]
2025-12-12 Update query-driver paths in settings.json and adjust delay timing in main.c
2025-12-26 Refactor RFM96 driver to generic sx127x driver
    Removed RFM96-specific driver headers and source files, and replaced them with generic sx127x driver files for both LoRa and FSK modes. Updated includes and references in main.c and CMakeLists.txt to use the new sx127x driver structure. This change generalizes the radio driver layer to support a wider range of Semtech SX127x-based chips.
    [main.c, sx127x.h, sx127x_lora.c, sx127x_lora.h]
2025-12-27 Refactor RFM96 driver to use SX127x driver
    - Replaced RFM96 driver includes with SX127x driver in main.c
    - Updated CMakeLists.txt to include SX127x source files
    - Added sx127x_common.h and sx127x_common.c for SX127x driver implementation
    - Implemented SPI communication functions for SX127x
    - Added basic read/write functions for SX127x registers
    - Implemented high-level functions for initializing the SX127x chip, setting frequency, transmit power, and overcurrent protection
    [main.c, sx127x.c, sx127x.h, sx127x_common.c, sx127x_common.h, sx127x_lora.c, sx127x_lora.h]
2025-12-27 Refactor SX127x LoRa driver and update main application
    - Modified sx127x_LORA_Init to use a struct for configuration parameters.
    - Introduced sx127x_LORA_ChangeMode for better mode management.
    - Added sx127x_LORA_TxSend and sx127x_LORA_RxReceive functions for sending and receiving data.
    - Updated main.c to initialize and use the new sx127x driver functions.
    - Removed deprecated RFM96_LORA functions and references.
    - Adjusted CMakeLists.txt to include the new driver files.
    - Cleaned up unused code and improved readability.
2025-12-27 Refactor SX127x driver: update FIFO size definition, improve FSK and LoRa header guards, enhance SPI transmission, and adjust power settings in main application
2025-12-29 Refactor sx127x LoRa driver and add new Python scripts
    - Updated sx127x_lora.h and sx127x_lora.c to change function names from Init to Config for clarity.
    - Improved register definitions and added comments for better readability in sx127x_lora.h.
    - Refactored sx127x_common.c to unify register write masks and improve function naming consistency.
    - Removed unused initialization code in sx127x.c and added a new function to get the frequency band.
    - Added a simple Tic-Tac-Toe game implementation in morpion.py and a hello world script in gfuyk.py.
2025-12-29 Refactor SX127x FSK and OOK driver implementation
    - Removed the existing sx127x_fsk.c file and replaced it with a new sx127x_fsk_ook.c file that consolidates FSK and OOK configurations.
    - Introduced a helper function to convert RxBw enum to register values.
    - Updated the FSK and OOK configuration functions to utilize a common internal configuration function.
    - Removed redundant LNA boost configuration from the LORA configuration function.
    - Adjusted CMakeLists.txt to include the new sx127x_fsk_ook.c file instead of the old sx127x_fsk.c file.
    [sx127x.h, sx127x_common.c, sx127x_common.h, sx127x_fsk_ook.c, sx127x_fsk_ook.h, sx127x_lora.c]
2025-12-29 Fix bitrate comments in sx127x_fsk_ook.h to reflect correct units (bps)
    [sx127x_fsk_ook.h]
2025-12-31 Refactor SX127x driver code to improve readability and consistency
    - Added new status codes for SPI and modem timeouts in sx127x_common.h
    - Updated bitrate definitions in sx127x_fsk_ook.h for clarity
    - Changed function names from `ChangeMode` to `SetMode` for consistency across LoRa and FSK/OOK drivers
    - Refactored FSK/OOK configuration functions to use a new chip structure for better encapsulation
    - Improved FIFO handling in FSK/OOK transmission and reception functions
    - Enhanced error handling and timeout management in FSK/OOK receive functions
    [sx127x_common.h, sx127x_fsk_ook.c, sx127x_fsk_ook.h, sx127x_lora.c, sx127x_lora.h]
2026-01-01 Refactor SX127x driver to enhance structure and readability; update FSK and LoRa configurations to use new chip structures and improve function signatures.
2026-01-02 TEST REUSSI FSK 200kbps (- de 64 bytes)
2026-01-03 Refactor LoRa driver functions and update main application logic
    - Introduced private helper functions `__sx127x_LORA_SetMode` and `__sx127x_LORA_IsTxDone` for better encapsulation and code organization.
    - Updated `sx127x_LORA_Config` and `sx127x_LORA_TxSend` to use the new helper functions.
    - Modified `sx127x_LORA_RxReceive` to implement a timeout mechanism for receiving packets.
    - Changed the main application to support both LoRa and FSK modulation configurations.
    - Improved the handling of transmission and reception logic, including dynamic delay adjustments based on modulation type.
    - Cleaned up commented-out code and organized the structure for better readability.
2026-02-22 Add driver configuration and implementation for ADXL345, BMI088, and BMP388; enable respective modules in main configuration
2026-02-22 Refactor driver configurations and initialization for improved modularity and clarity; update type definitions and function signatures for consistency across drivers.
2026-02-28 Enhance BMI088 driver documentation and improve SPI function clarity
    - Updated file header to provide detailed information about the BMI088 driver, including abstraction layers and usage notes.
    - Added documentation comments for SPI functions: BMI088_SPI_Begin, BMI088_SPI_Tx, BMI088_SPI_Rx, and BMI088_SPI_End.
    - Clarified parameters and return values in the function documentation to improve code readability and maintainability.
2026-03-01 Update BMI088 driver: add read-only comment and adjust bandwidth range checks in test
2026-03-01 Refactor project.c and CMakeLists.txt: update loop function for USB CDC stability and adjust include paths for W25Q_USB project
    [project.c]
2026-03-01 Réorganisation complète du projet, généralisation des tests
2026-03-01 Add unit tests for data topic functionality
    - Created a new header file `dt_seq_test.h` to define test cases for the data topic API.
    - Implemented the corresponding source file `dt_seq_test.c` containing 12 test cases covering various scenarios:
    - NULL argument protection
    - Basic publish/read FIFO functionality
    - Handling of empty reads
    - Subscriber attachment modes (FROM_OLDEST and FROM_NOW)
    - Subscriber independence and data loss scenarios
    - Non-destructive peek functionality
    - Behavior under reject new policy
    These tests ensure the robustness and correctness of the data topic implementation.
    [drivers_config.c, drivers_config.h]
2026-03-01 feat(tests): Enhance testing framework and add new configurations
    - Added new utility functions for test case management in `test.h` and `test.c`, including `TEST_get_pass_fail_count`.
    - Updated the test assertion macro `TEST_ASSERT` to provide detailed failure messages.
    - Modified the CMake configuration to point to the new test project directory `SEQ_ALL_TESTS_USB`.
    - Introduced new configuration headers (`drivers_config.h`, `main_config.h`, `project.h`, `tests_config.h`) for better modularity and control over enabled features.
    - Implemented driver configurations in `drivers_config.c` for various sensors and components, ensuring proper initialization sequences.
    - Created a comprehensive te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
    [BMI088_seq_test.c, drivers_config.c, drivers_config.h, dt_seq_test.c, main_config.c, main_config.h, project.c]
2026-03-15 Update dependencies and refactor vector and quaternion libraries
    - Updated versions of various dependencies in bundles.store.json for improved compatibility and features.
    - Replaced "types.h" with "float3.h" in multiple source files to streamline vector operations.
    - Removed the obsolete "types.h" and its implementation, consolidating vector functionality into "float3.h".
    - Introduced a new "quaternion" library for quaternion mathematics, including operations for addition, subtraction, multiplication, and normalization.
    - Added quaternion dynamics functions for propagating attitude based on angular rates.
    - Implemented vector rotation using quaternions and ensured proper handling of quaterni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
    [BMI088.c, BMI088.h, tools.c, tools.h]
2026-03-15 refactor: Update peripheral includes and improve data structures for sensor readings
2026-03-29 Add RTOS support for BMI088 and W25Q initialization and data handling
    - Introduced main_config.c to enforce single schedule profile and profile selection.
    - Implemented project.c for managing initialization and data acquisition tasks for BMI088 and W25Q.
    - Enhanced BMI088 driver to support timestamped data readings and periodic task execution.
    - Updated W25Q driver to include RTOS task management for command execution.
    - Modified data_topic library to support semaphore-based data waiting.
    - Adjusted circular_buffer and scheduler libraries for compatibility with new features.
    - Updated CMakeLists.txt to point to the new project path for RTOS integration.
2026-03-29 refactor: Simplify LED structure and update related functions; add waveform utility functions
2026-03-29 Update FreeRTOS configuration and peripheral initialization
    - Enhanced FreeRTOS configuration by enabling application task tagging, tickless idle support, and additional API inclusions for better task management.
    - Updated GPIO pin definitions for clarity and corrected CS_GYRO to CS_GRYO.
    - Removed unused ADC variables and included necessary headers.
    - Updated copyright year from 2025 to 2026 in multiple peripheral header and source files.
    - Improved SPI and TIM initialization functions for better readability and error handling.
    - Added PWM configuration for TIM2 and ensured proper GPIO initialization for PWM outputs.
    - Cleaned up interrupt handler by removing unused variables.
    [APEX_v1_0.ioc, main.h, spi.c, spi.h]
2026-03-29 feat: Add sequential LED PWM project with driver and main configuration files
2026-04-06 feat: Enhance LED PWM functionality and waveform management
    - Added RGB LED configuration in drivers_config.h for led0 and led1.
    - Included scheduler.h in project.h for task scheduling support.
    - Initialized RGB LEDs in drivers_config.c with appropriate timer channels.
    - Updated project.c to remove redundant LED initialization and adjusted waveform handling.
    - Refactored waveform management by introducing waveform_def.h for common structures and functions.
    - Implemented scalar and space waveform arithmetic in separate header and source files.
    - Updated CMakeLists.txt to include new waveform source files and adjusted project path.
2026-04-19 Add initial configuration and driver support for SEQ_LED_PWM and SEQ_W25Q_USB projects
    - Created main_config.h and project.h for both projects to manage configurations and module enables.
    - Implemented drivers_config.c to handle initialization and configuration of various hardware drivers.
    - Added main_config.c to enforce configuration constraints for scheduling profiles and mission profiles.
    - Developed project.c for SEQ_LED_PWM to manage LED control using waveform functions.
    - Established USB communication in SEQ_W25Q_USB for test result output.
    - Introduced sequential test cases for W25Q driver functionality.
2026-05-06 update APEX pin mapping
2026-05-08 fix timer
2026-05-09 Add WT901B IMU driver implementation and integrate into project
    - Implemented WT901B.c for parsing and handling data from the WT901B IMU.
    - Updated main_config.h to enable WT901B support.
    - Modified project.c to initialize WT901B and handle accelerometer data.
    - Included WT901B header and data topic management in project.c.
    - Updated CMakeLists.txt to include WT901B driver source and headers.
2026-05-09 feat: Implement UART multiplexing functionality and update related configurations
2026-05-09 Refactor UART and I2C Mux functionality
    - Commented out USB device initialization in main.c to disable USB functionality.
    - Updated UART callback to use channel-based logic instead of state-based.
    - Introduced I2C Mux driver with header and source files for channel selection.
    - Modified UART Mux to use channel enumeration instead of boolean state.
    - Added configuration files for sequential test projects, including drivers and main configurations.
    - Implemented setup and loop functions for sequential test projects, integrating UART and I2C Mux functionality.
    - Updated CMakeLists to include new I2C and UART Mux drivers in the build process.
2026-05-14 feat: Update GPIO and UART configurations, modify SEQ_DA handling, and adjust project structure
2026-10-04 W25Q: split sequential/RTOS driver, add RTOS test suite and perf bench
    Driver
    - Split the W25Q driver into w25q.c (blocking HAL, sequential) and
    w25q_rtos.c (DMA + chip semaphore + TASK_DECLARE'd tasks); drop
    w25q_tasks.{c,h}.
    - WaitForReady_RTOS: spin for the first W25Q_RTOS_SPIN_MS (2 ms, covers a
    page program), then poll once per tick with osDelay(1). Erases no longer
    starve lower-priority tasks (0% -> ~93% CPU left), at the cost of slower
    32/64 KB erases (64 KB: ~200 -> ~280 ms, measured A/B). 4 KB erases and
    page program are unchanged.
    - Init: dummy JEDEC ID read before the real one; the first SPI2 transaction
    after reset returned a corrupted ID (EF 40 00).
    SPI / RTOS
    - R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
    [BMI088_seq_test.c, drivers_config.c, drivers_config.h, main.c, main_config.c]
2026-10-04 BMI088: split sequential/RTOS driver, add RTOS test suite and perf bench
    - Split the BMI088 driver into BMI088.c (blocking HAL, sequential) and
    BMI088_rtos.c (DMA + sensor semaphore + TASK_DECLARE'd tasks). The old
    TASK_POOL_CONFIGURE ReadAcc/ReadGyr/ReadTemp tasks are replaced by
    BMI088_Init, BMI088_ApplyConfig and BMI088_Acquire (periodic, paced by
    osDelayUntil, publishes timestamped samples on data_topic, counts
    overruns/errors, no catch-up burst after a stall).
    - bmi_config_t now holds the bus (hspi + both CS) and the register config;
    BMI088_Init(imu, &config). All drivers_config.c updated accordingly.
    - Multi-step sequences (soft reset, ApplyConfig, bring-up) written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
    [BMI088.c, BMI088.h, BMI088_rtos.c, BMI088_rtos.h, BMI088_rtos_bench.c, BMI088_rtos_bench.h, BMI088_rtos_test.c, BMI088_rtos_test.h]
2026-10-05 Add new tests and configurations for sequential and RTOS-based data handling
    - Introduced main_config.c and project.c for RTOS_DT_USB tests, ensuring proper configuration checks for scheduling profiles and mission profiles.
    - Added project.c for DP_USB tests, implementing setup and loop functions for data packet tests.
    - Created drivers_config.h and drivers_config.c to manage hardware driver configurations, including ADXL345, BMI088, BMP388, and others.
    - Implemented main_config.h for defining main configuration settings, including schedule profiles and module enable/disable flags.
    - Updated project.h to include necessary headers and function prototypes for sequential data packet tests.
    - En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
2026-10-08 Data core audit fixes, BMI088 DelayUs hang fix, on-target test tooling
    data_topic:
    - Replace the intrusive subscriber list with a fixed registry
    (DATA_TOPIC_MAX_SUBS = 8, DT_NO_SLOT on overflow). An invalid
    subscriber is skipped, freed and counted in list_faults without
    affecting the others (fixes sub_count dropping below the real count
    and refusing every later attach).
    - Bound every traversal; cursor consistency check in dt_access turns a
    pub_seq wrap (2^32 publications) into DT_DATA_LOSS instead of
    out-of-order reads.
    data_packet: bound the stale-sample rejection loop in data_packer_check.
    Tests: new CB/DT/DP sequential cases and DT RTOS cases (registry,
    regressions, wrap, bo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
    [BMI088.c, BMI088_rtos_bench.c, dp_seq_test.c]
