povdoigt/Apex/(notices)

Notices in the files:
KODE/APEX_v1_1/Core/Src/tim.c:
Copyright (c) 2026 STMicroelectronics.
All rights reserved.
This software is licensed under terms that can be found in the LICENSE file
KODE/APEX_v1_1/Core/Inc/main.h:
Copyright (c) 2025 STMicroelectronics.
